idank/keyboards/README.md

# About

This repo contains pcb and 3d files for keyboards. The keyboards are adaptations of popular open source keyboards with a variety of changes.

# Buy

Check [holykeebs.com][hk] for kits and prebuilt keyboards.

# License

This work is licensed under a
[Creative Commons Attribution-ShareAlike 4.0 International License][cc-by-sa].

[cc-by-sa]: http://creativecommons.org/licenses/by-sa/4.0/
[hk]: https://holykeebs.com
