idank/keyboards/chocorne hotswap/oled cover.dxf

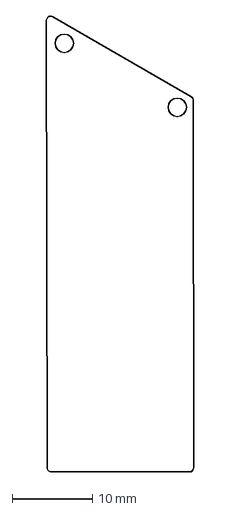
[picture p1: CAD file, 2023-08-10]
chocorne hotswap/oled cover.dxf
18.3 x 56.7 mm
