idank/keyboards/corne/corne-light-smt/for smt.dxf

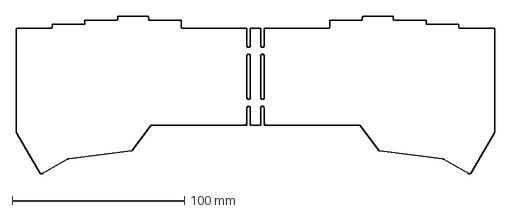
[picture p2: CAD file, 2024-01-29]
corne/corne-light-smt/for smt.dxf
277.5 x 91.4 mm
