idank/keyboards/lily58/choc plates/outline.dxf

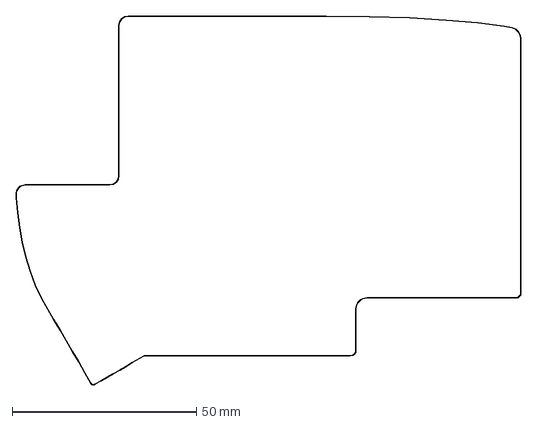
[picture p3: CAD file, 2024-03-17]
lily58/choc plates/outline.dxf
137.0 x 100.1 mm
