idank/keyboards/lily58/mx smt/smt.dxf

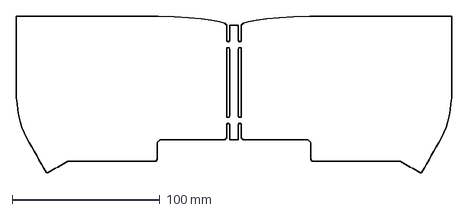
[picture p4: CAD file, 2024-03-26]
lily58/mx smt/smt.dxf
295.0 x 106.3 mm
