idank/keyboards/mbk-3dmodels/1u.stl

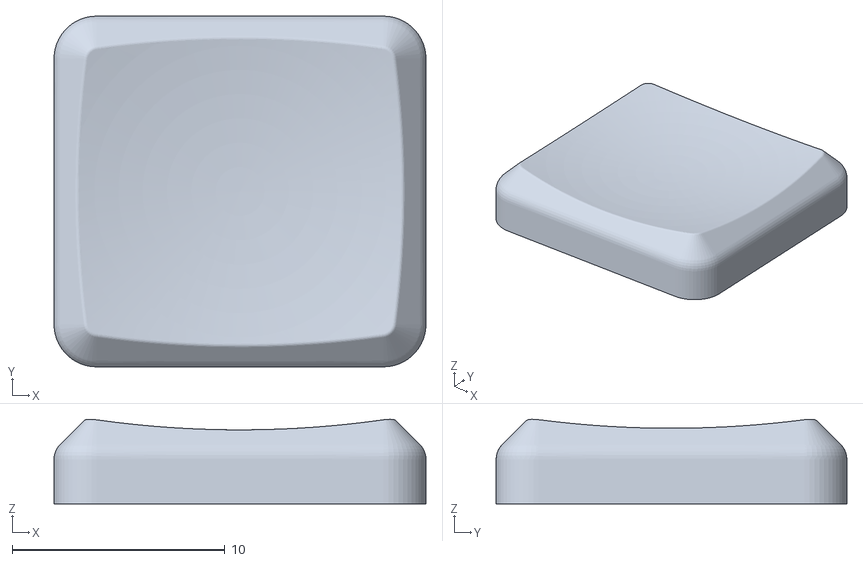
[picture p5: CAD file, 2023-08-22]
mbk-3dmodels/1u.stl
17.5 x 16.5 x 3.98
