idank/keyboards/printed-cases/corne low profile, 4mm spacers.stl

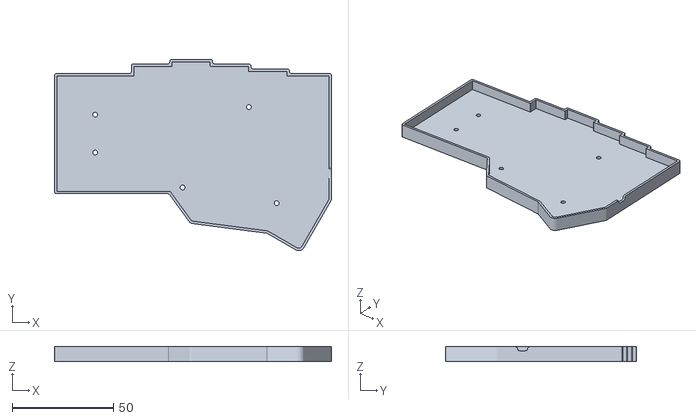
[picture p6: CAD file, 2026-04-15]
printed-cases/corne low profile, 4mm spacers.stl
137.0 x 94.6 x 7.20
