idank/keyboards/reviung/reviung41 choc/plate/41_1350_pcb_plate.step

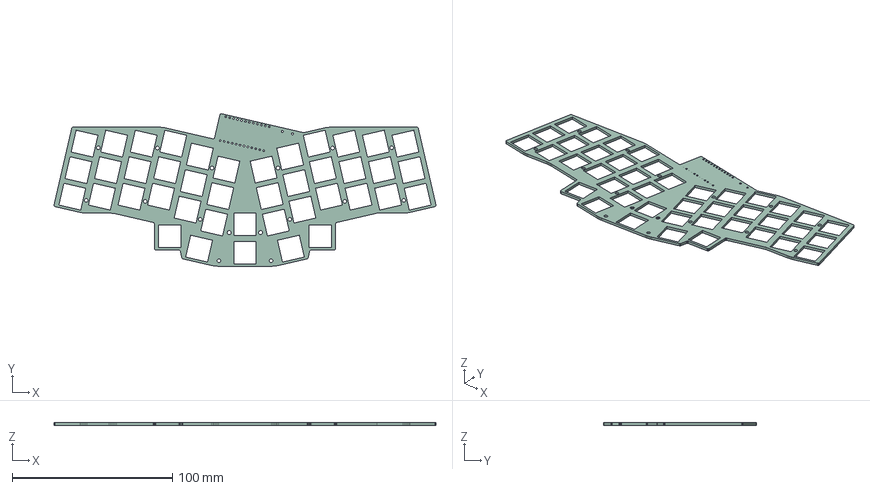
[picture p7: CAD file, 2023-06-27]
reviung/reviung41 choc/plate/41_1350_pcb_plate.step
238.7 x 95.3 x 1.58 mm
