idank/keyboards/reviung/reviung41 low profile/pcb/bottom plate.dxf

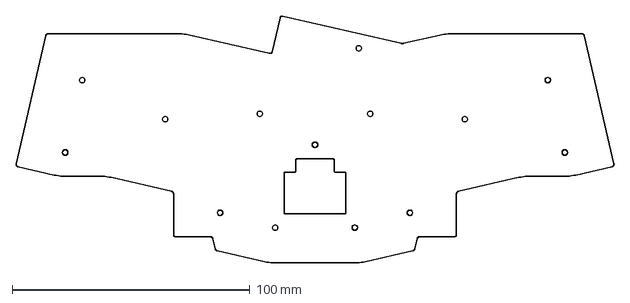
[picture p8: CAD file, 2023-08-24]
reviung/reviung41 low profile/pcb/bottom plate.dxf
251.3 x 103.7 mm
