idank/keyboards/reviung/reviung41 low profile/plate/reviung41 low profile plate.STEP

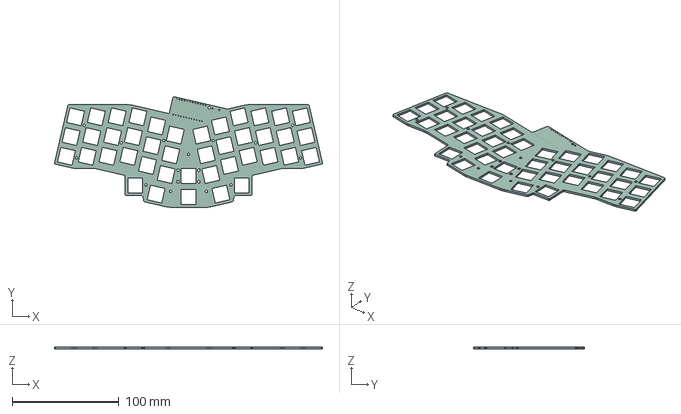
[picture p9: CAD file, 2023-07-04]
reviung/reviung41 low profile/plate/reviung41 low profile plate.STEP
251.3 x 103.7 x 1.60 mm
