idank/keyboards/sweeq/sweeq plate tenting holes.STEP

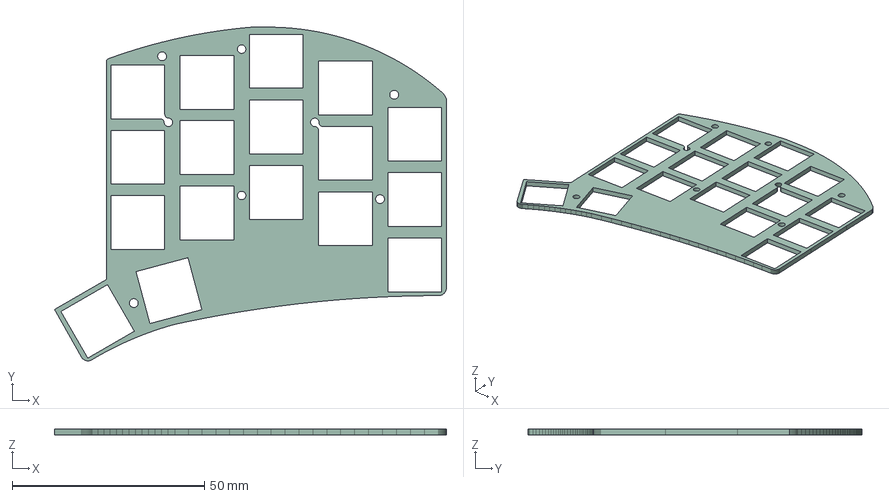
[picture p10: CAD file, 2024-02-10]
sweeq/sweeq plate tenting holes.STEP
102.0 x 86.9 x 1.58 mm
