idank/keyboards/TPS42/Case/3dp/outlines/keycaps_outline_3x6.dxf

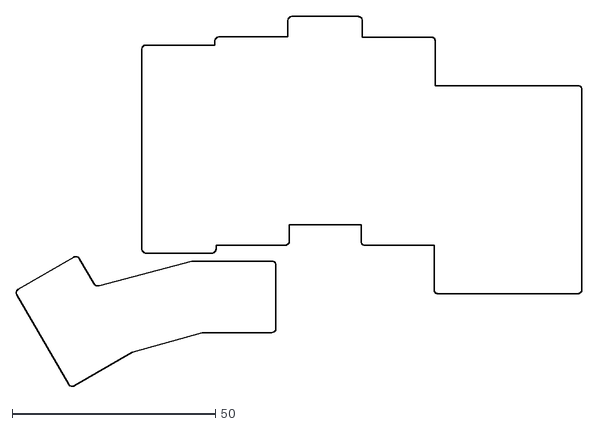
[picture p11: CAD file, 2023-07-06]
TPS42/Case/3dp/outlines/keycaps_outline_3x6.dxf
139.3 x 91.2
