idank/keyboards/TPS42/PCB/TPS42/TPS42.step

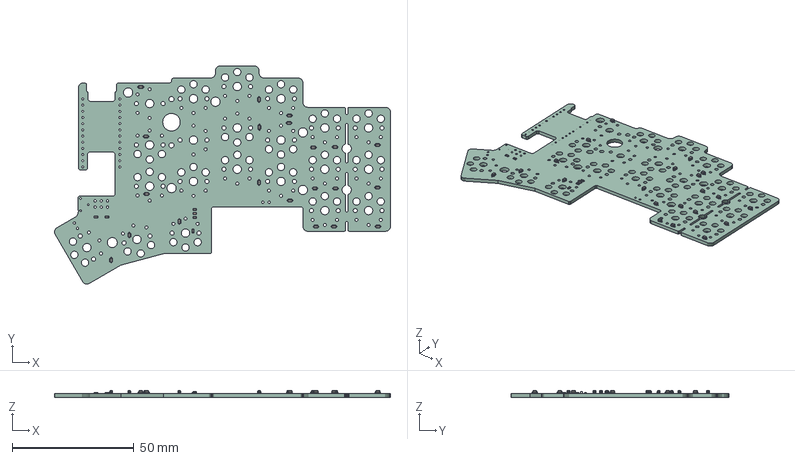
[picture p12: CAD file, 2023-07-06]
TPS42/PCB/TPS42/TPS42.step
138.1 x 89.7 x 2.73 mm
PCB
