idank/keyboards/chocorne hotswap/chococorne hotswap plate.step

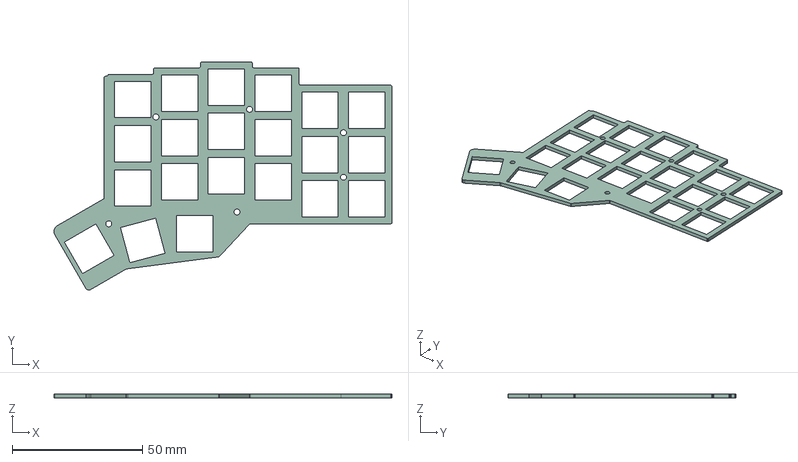
[picture p13: CAD file, 2023-08-10]
chocorne hotswap/chococorne hotswap plate.step
130.0 x 87.7 x 1.58 mm
