idank/keyboards/corne/corne-light-smt/corne-light-brd.dxf

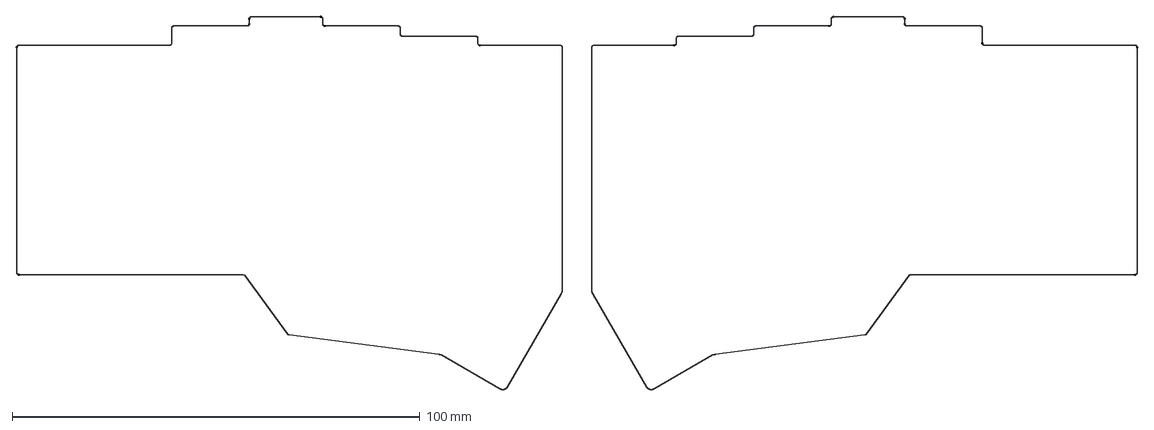
[picture p14: CAD file, 2024-01-29]
corne/corne-light-smt/corne-light-brd.dxf
274.9 x 91.5 mm
