idank/keyboards/lily58/mx smt/Lily58.step

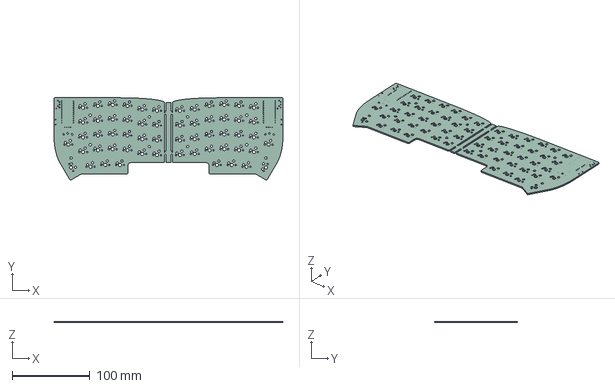
[picture p15: CAD file, 2024-03-26]
lily58/mx smt/Lily58.step
295.0 x 106.3 x 1.60 mm
