idank/keyboards/mbk-3dmodels/1.5ux.stl

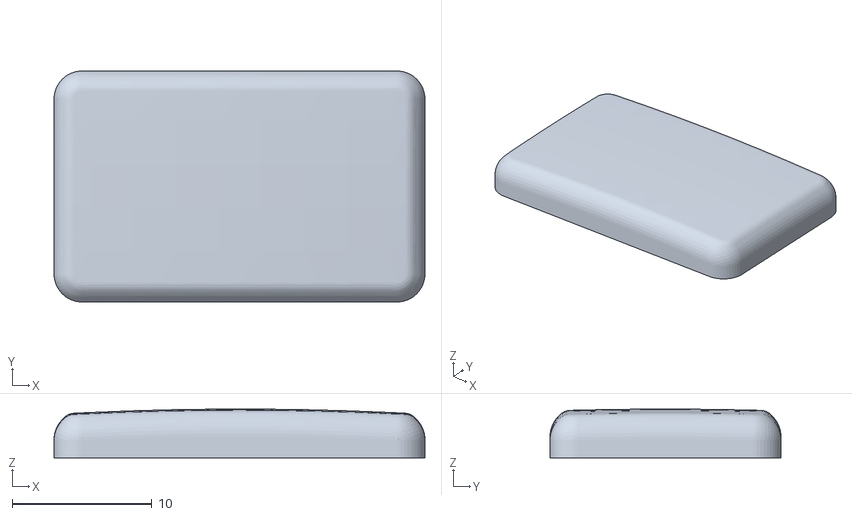
[picture p16: CAD file, 2023-08-22]
mbk-3dmodels/1.5ux.stl
26.5 x 16.5 x 3.49
