idank/keyboards/printed-cases/corne cherry low profile sockets, 7mm spaces, 1.2mm top.3mf

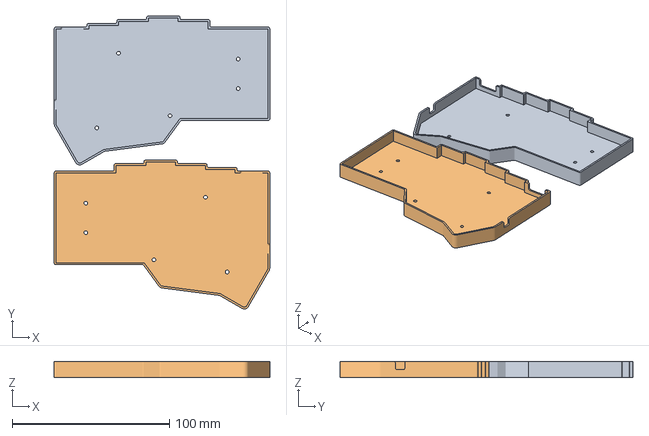
[picture p17: CAD file, 2026-04-15]
printed-cases/corne cherry low profile sockets, 7mm spaces, 1.2mm top.3mf
137.0 x 186.1 x 10.2 mm
corne cherry low profile sockets, 7mm spaces, 1.2mm top.stl x 2
