idank/keyboards/sweeq/sweeq.dxf

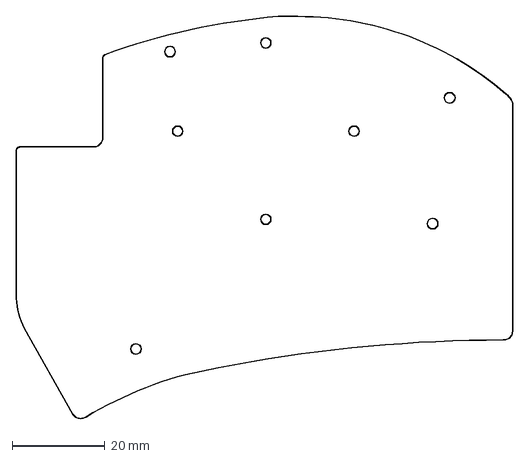
[picture p18: CAD file, 2023-09-06]
sweeq/sweeq.dxf
107.2 x 86.9 mm
