idank/keyboards/TPS42/Case/3dp/outlines/pcb_outline.dxf

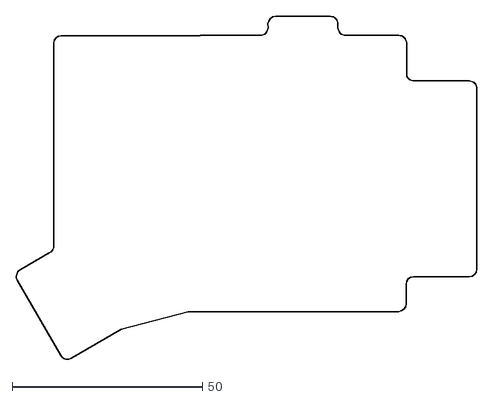
[picture p19: CAD file, 2023-07-06]
TPS42/Case/3dp/outlines/pcb_outline.dxf
121.1 x 90.2
