idank/keyboards/chocorne hotswap/chococorne hotswap.step

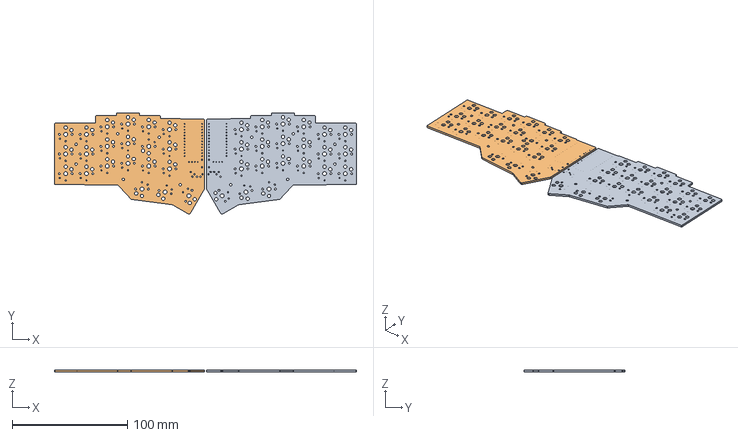
[picture p20: CAD file, 2023-07-17]
chocorne hotswap/chococorne hotswap.step
261.7 x 87.7 x 1.58 mm
PCB1
PCB2
