idank/keyboards/mbk-3dmodels/2ux.stl

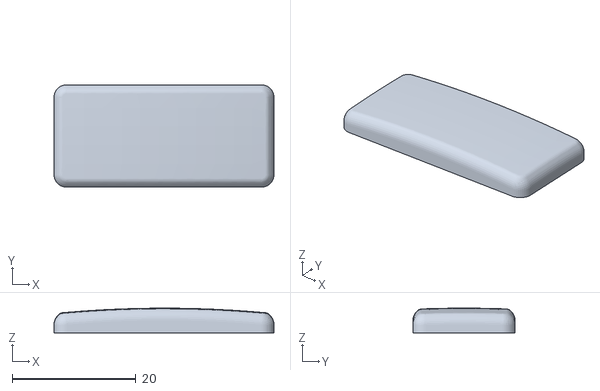
[picture p21: CAD file, 2023-08-22]
mbk-3dmodels/2ux.stl
35.5 x 16.5 x 3.99
