idank/keyboards/printed-cases/lily58 mx, 7mm spacers low profile sockets.3mf

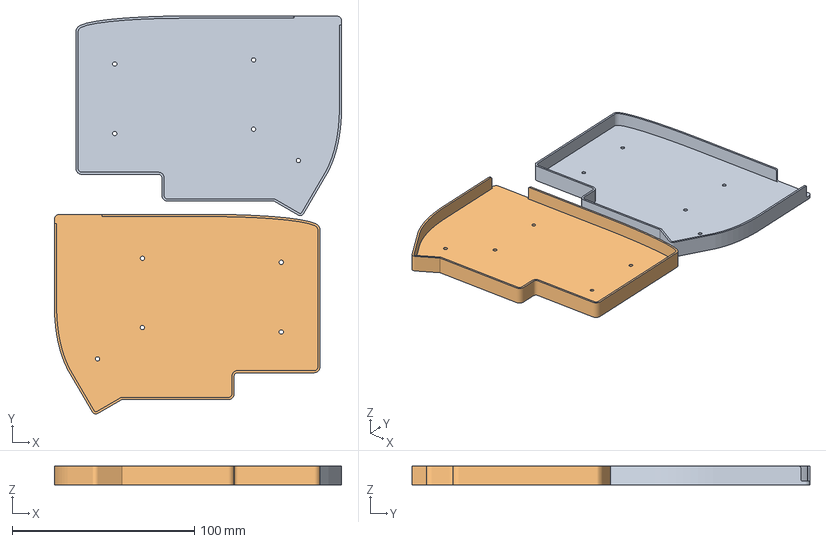
[picture p22: CAD file, 2026-04-15]
printed-cases/lily58 mx, 7mm spacers low profile sockets.3mf
157.5 x 218.4 x 10.2 mm
lily58 mx, 7mm spacers low profile sockets.stl x 2
