idank/keyboards/sweeq/sweeq plate with tenting holes.dxf

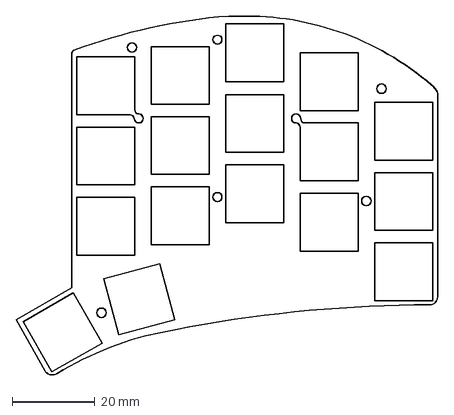
[picture p23: CAD file, 2023-09-03]
sweeq/sweeq plate with tenting holes.dxf
102.0 x 86.9 mm
