idank/keyboards/TPS42/Case/3dp/outlines/keycaps_outline.dxf

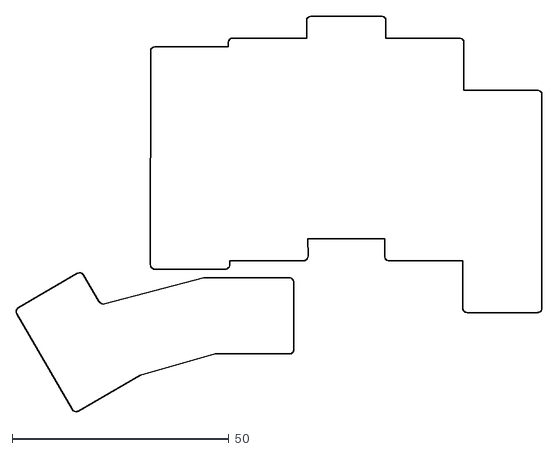
[picture p24: CAD file, 2023-07-06]
TPS42/Case/3dp/outlines/keycaps_outline.dxf
121.2 x 91.2
