idank/keyboards/chocorne hotswap/chococorne-Edge_Cuts.dxf

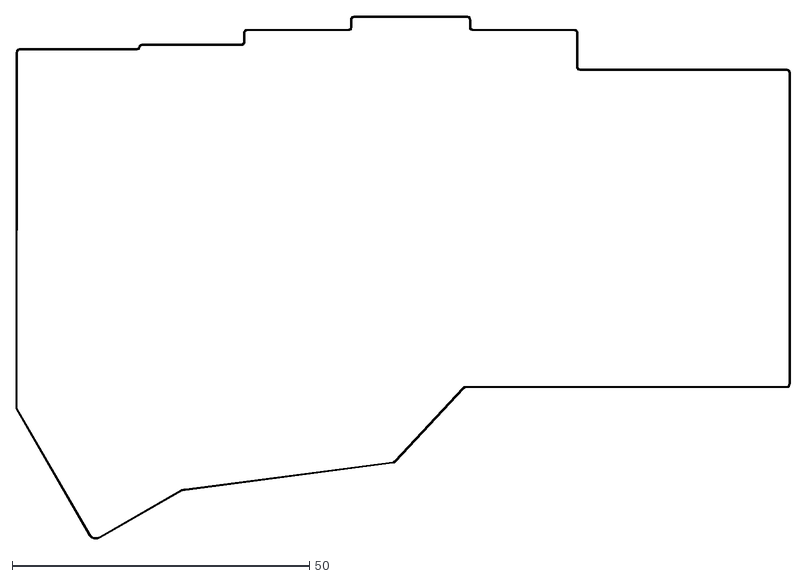
[picture p25: CAD file, 2023-07-16]
chocorne hotswap/chococorne-Edge_Cuts.dxf
130.1 x 87.9
