idank/keyboards/mbk-3dmodels/2.25u.stl

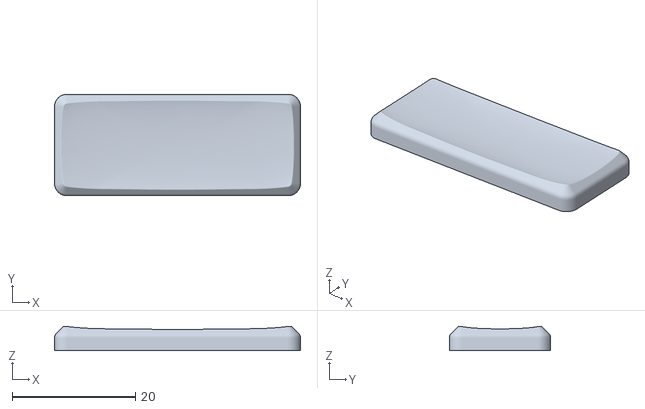
[picture p26: CAD file, 2023-08-22]
mbk-3dmodels/2.25u.stl
40.0 x 16.5 x 3.97
