idank/keyboards/printed-cases/lily lp 4mm spacers 1.6.3mf

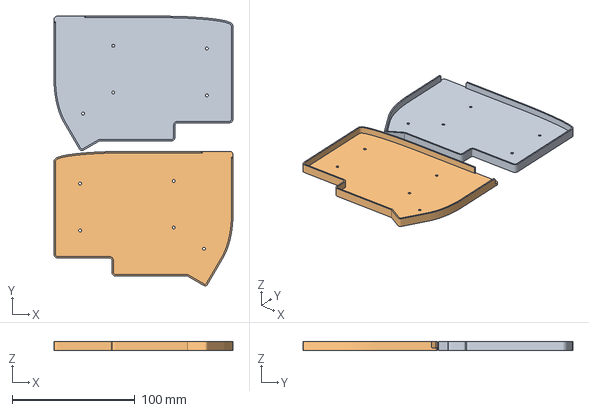
[picture p27: CAD file, 2026-04-15]
printed-cases/lily lp 4mm spacers 1.6.3mf
145.7 x 219.6 x 7.60 mm
lily lp 4mm spacers 1.6.stl x 2
