idank/keyboards/TPS42/Case/3dp/outlines/switch_outline.dxf

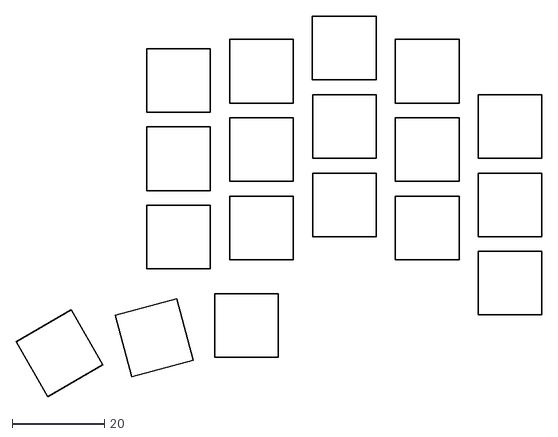
[picture p28: CAD file, 2023-07-06]
TPS42/Case/3dp/outlines/switch_outline.dxf
114.2 x 82.5
