idank/keyboards/chocorne hotswap/chococorne.step

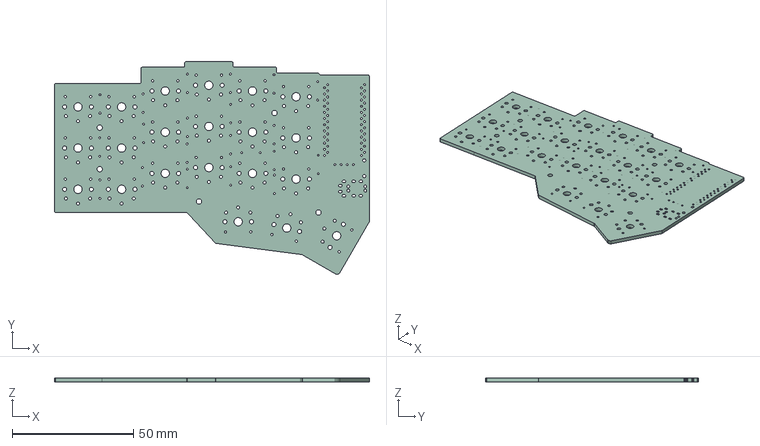
[picture p29: CAD file, 2023-05-10]
chocorne hotswap/chococorne.step
130.0 x 87.7 x 1.60 mm
