idank/keyboards/mbk-3dmodels/2.75u.stl

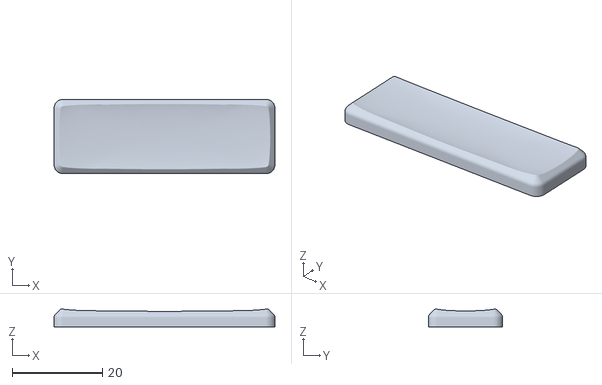
[picture p30: CAD file, 2023-08-22]
mbk-3dmodels/2.75u.stl
49.0 x 16.5 x 3.97
