idank/keyboards/printed-cases/sweeq, 4mm spacers.3mf

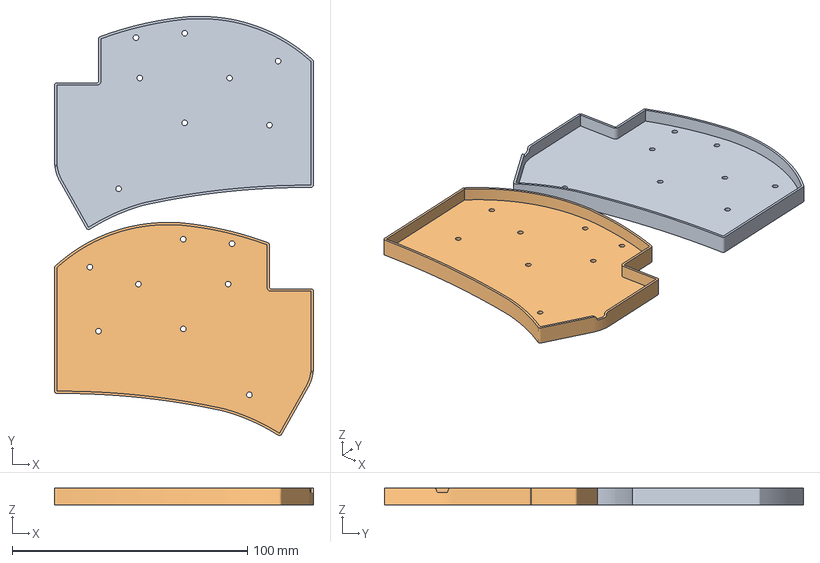
[picture p31: CAD file, 2026-04-15]
printed-cases/sweeq, 4mm spacers.3mf
110.0 x 178.1 x 7.20 mm
sweeq, 4mm spacers.stl x 2
