idank/keyboards/TPS42/Case/3dp/outlines/pcb_outline_3x6.dxf

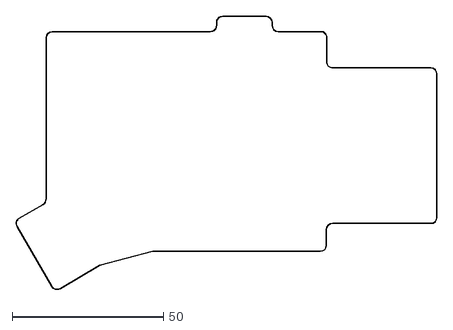
[picture p32: CAD file, 2023-07-06]
TPS42/Case/3dp/outlines/pcb_outline_3x6.dxf
139.0 x 90.2
