idank/keyboards/mbk-3dmodels/1.5u.stl

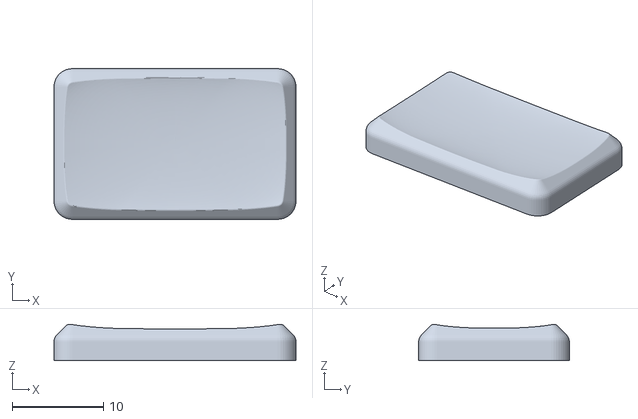
[picture p33: CAD file, 2023-08-22]
mbk-3dmodels/1.5u.stl
26.5 x 16.5 x 3.97
