idank/keyboards/printed-cases/span, 5mm spacers.3mf

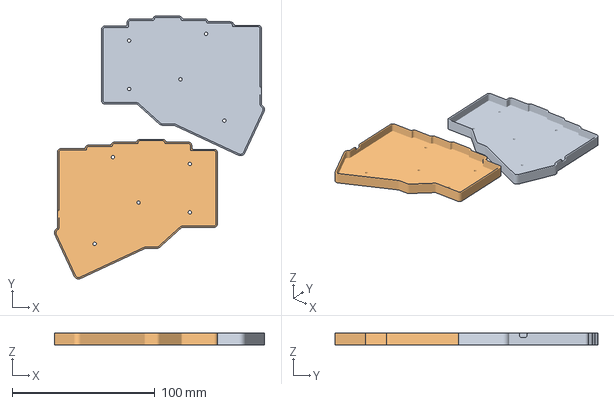
[picture p34: CAD file, 2026-04-15]
printed-cases/span, 5mm spacers.3mf
147.5 x 184.6 x 8.20 mm
span, 5mm spacers.stl x 2
