idank/keyboards/TPS42/Case/3dp/outlines/switch_outline_3x6.dxf

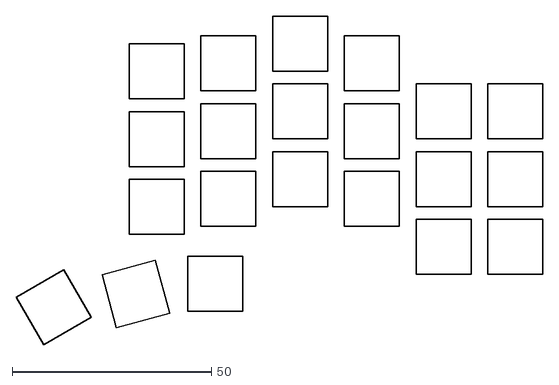
[picture p35: CAD file, 2023-07-06]
TPS42/Case/3dp/outlines/switch_outline_3x6.dxf
132.1 x 82.5
