idank/keyboards/mbk-3dmodels/2u.stl

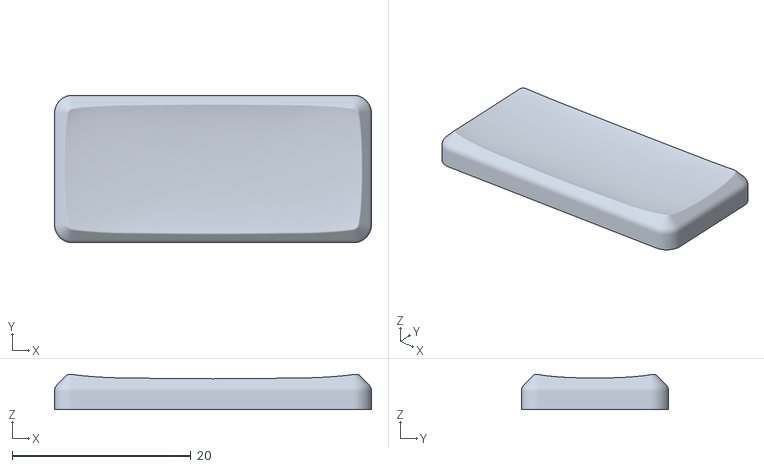
[picture p36: CAD file, 2023-08-22]
mbk-3dmodels/2u.stl
35.5 x 16.5 x 3.97
