idank/keyboards/printed-cases/corne choc, 4mm spacers.3mf

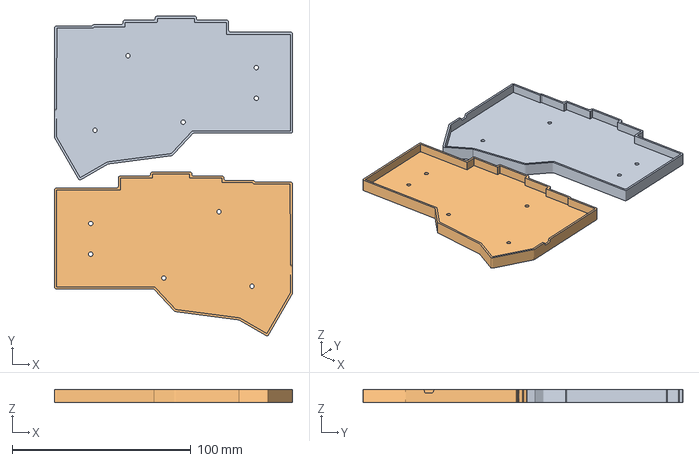
[picture p37: CAD file, 2026-04-15]
printed-cases/corne choc, 4mm spacers.3mf
133.2 x 178.9 x 7.20 mm
corne choc, 4mm spacers.stl x 2
