idank/keyboards/mbk-3dmodels/1uh.stl

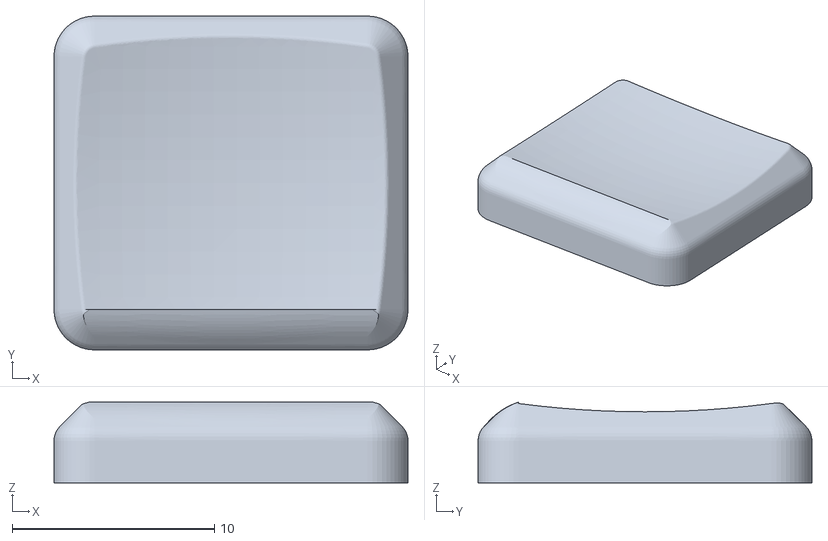
[picture p38: CAD file, 2023-08-22]
mbk-3dmodels/1uh.stl
17.5 x 16.5 x 4.00
