idank/keyboards/printed-cases/span, 4mm spacers.stl

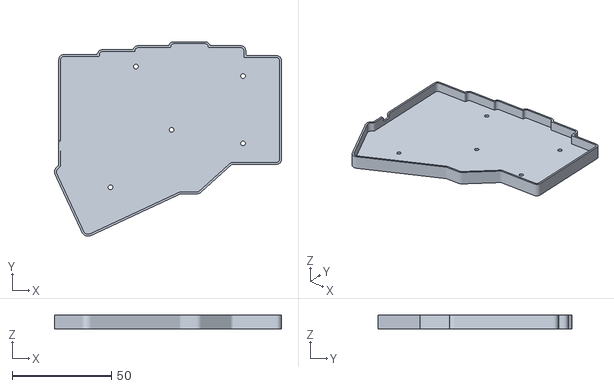
[picture p39: CAD file, 2026-04-15]
printed-cases/span, 4mm spacers.stl
114.4 x 98.0 x 7.20
