idank/keyboards/mbk-3dmodels/1.75u.stl

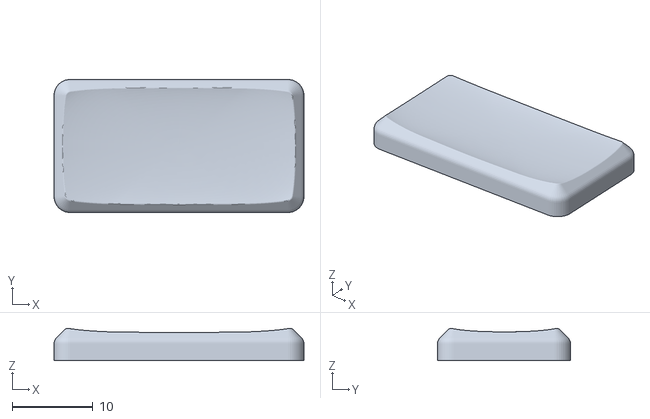
[picture p40: CAD file, 2023-08-22]
mbk-3dmodels/1.75u.stl
31.0 x 16.5 x 3.97
