idank/keyboards/printed-cases/lily choc 4mm spacers.3mf

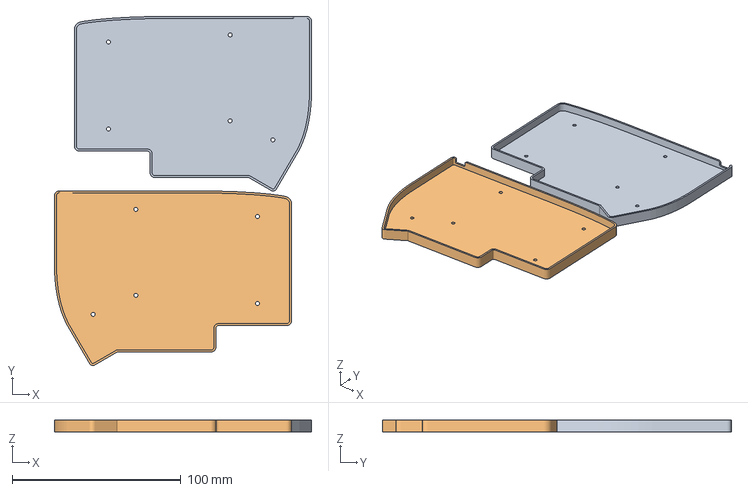
[picture p41: CAD file, 2026-04-15]
printed-cases/lily choc 4mm spacers.3mf
152.1 x 206.6 x 7.20 mm
lily choc 4mm spacers.stl x 2
