idank/keyboards/mbk-3dmodels/6.25ux.stl

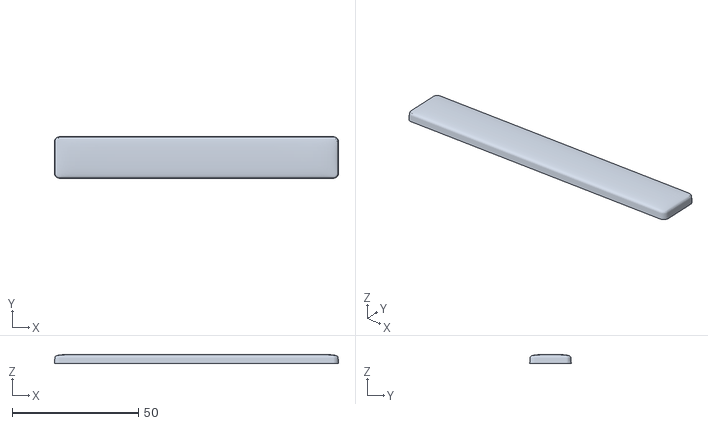
[picture p42: CAD file, 2023-08-22]
mbk-3dmodels/6.25ux.stl
112.5 x 16.5 x 3.74
