idank/keyboards/printed-cases/sweeq mx low profile sockets.3mf

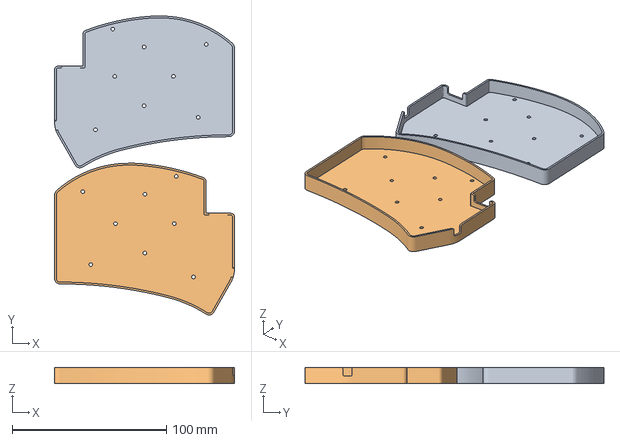
[picture p43: CAD file, 2026-04-15]
printed-cases/sweeq mx low profile sockets.3mf
116.7 x 193.7 x 10.6 mm
sweeq mx low profile sockets.stl x 2
