idank/keyboards/mbk-3dmodels/1.25u.stl

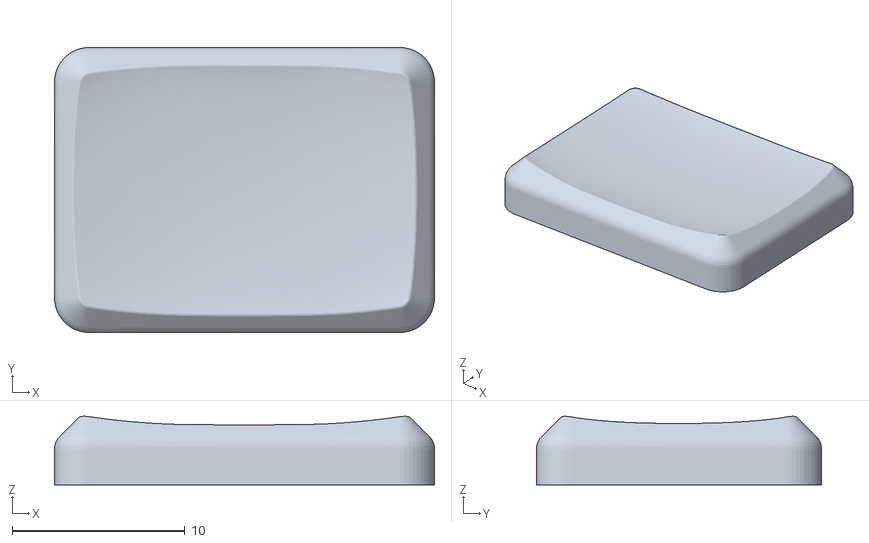
[picture p44: CAD file, 2023-08-22]
mbk-3dmodels/1.25u.stl
22.0 x 16.5 x 3.97
