idank/keyboards/printed-cases/touchpad cover right.stl

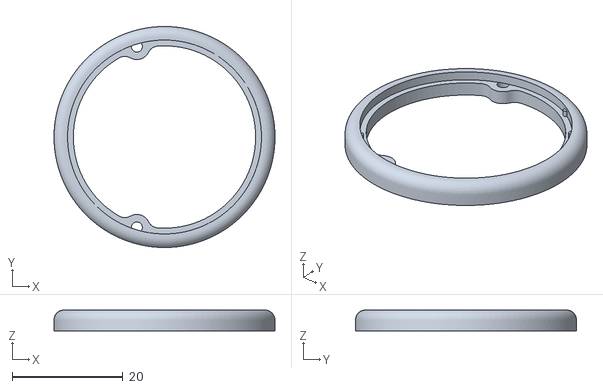
[picture p45: CAD file, 2024-04-29]
printed-cases/touchpad cover right.stl
40.0 x 40.0 x 3.80
