idank/keyboards/printed-cases/corne choc.dxf

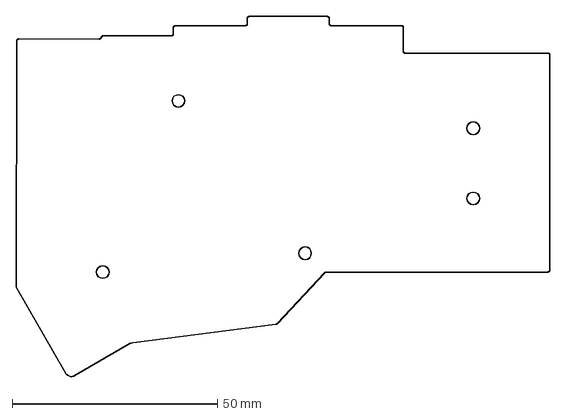
[picture p46: CAD file, 2024-04-29]
printed-cases/corne choc.dxf
130.0 x 87.7 mm
