idank/keyboards/printed-cases/touchpad cover left.stl

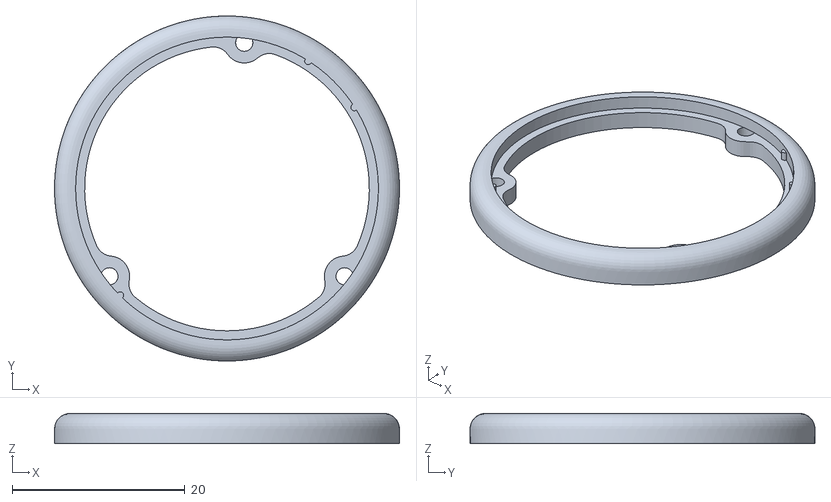
[picture p47: CAD file, 2024-04-29]
printed-cases/touchpad cover left.stl
40.0 x 40.0 x 3.50
