idank/keyboards/printed-cases/lily58, 4mm spacers, trackpoint groove.stl

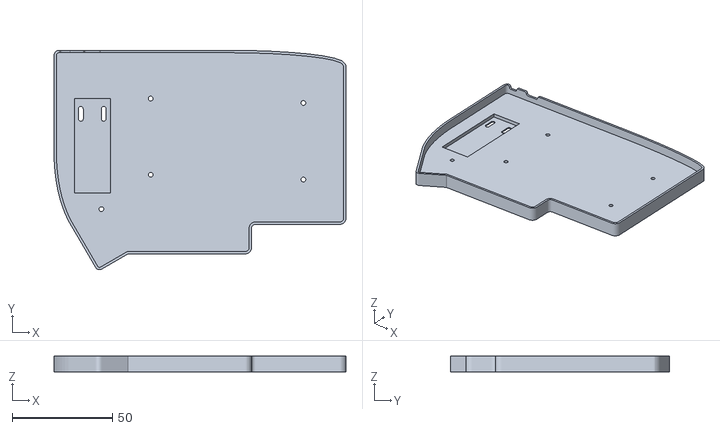
[picture p48: CAD file, 2024-04-29]
printed-cases/lily58, 4mm spacers, trackpoint groove.stl
145.7 x 109.5 x 7.80
