idank/keyboards/printed-cases/1mm_spacer.stl

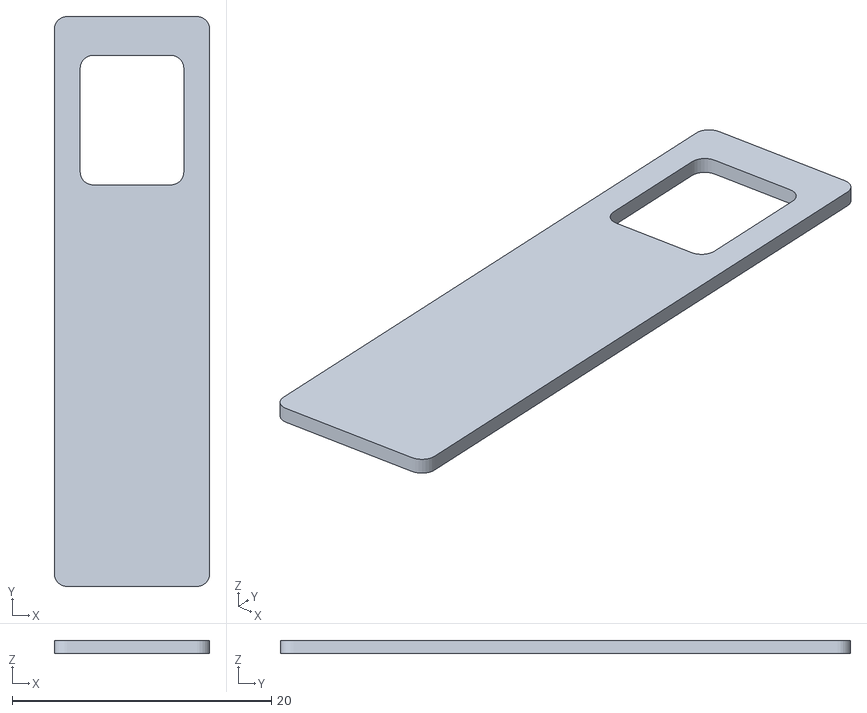
[picture p49: CAD file, 2024-04-29]
printed-cases/1mm_spacer.stl
12.0 x 44.0 x 1.00
