idank/keyboards/printed-cases/case.step

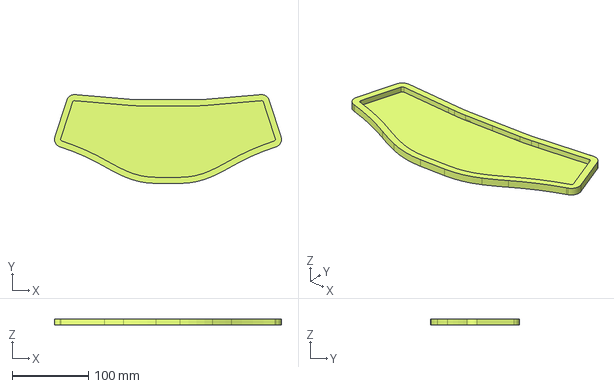
[picture p50: CAD file, 2024-04-29]
printed-cases/case.step
297.1 x 116.3 x 8.00 mm
