idank/keyboards/printed-cases/lily58, 4mm spacers.stl

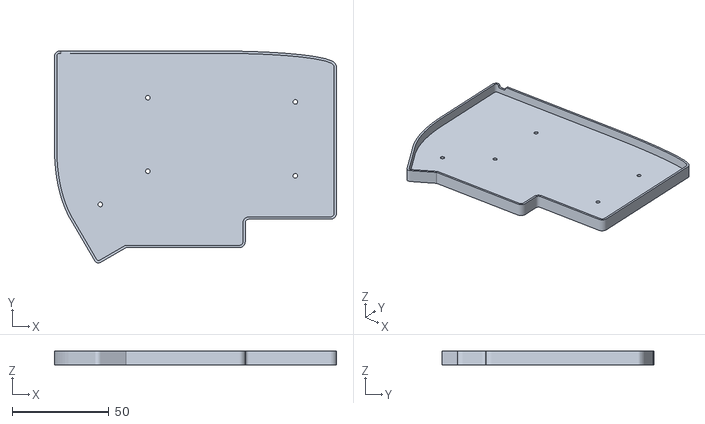
[picture p51: CAD file, 2024-04-29]
printed-cases/lily58, 4mm spacers.stl
145.7 x 109.5 x 7.20
