idank/keyboards/printed-cases/lily58 mx, 8mm spacers.stl

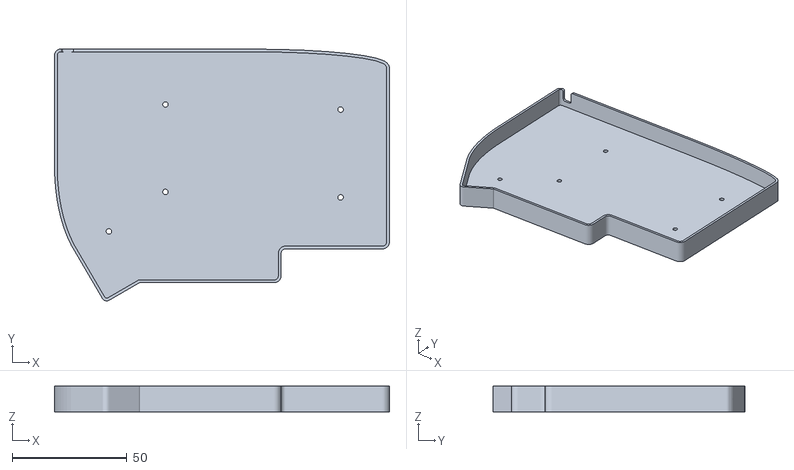
[picture p52: CAD file, 2024-04-29]
printed-cases/lily58 mx, 8mm spacers.stl
145.7 x 109.5 x 11.2
