idank/keyboards/printed-cases/sample rect.stl

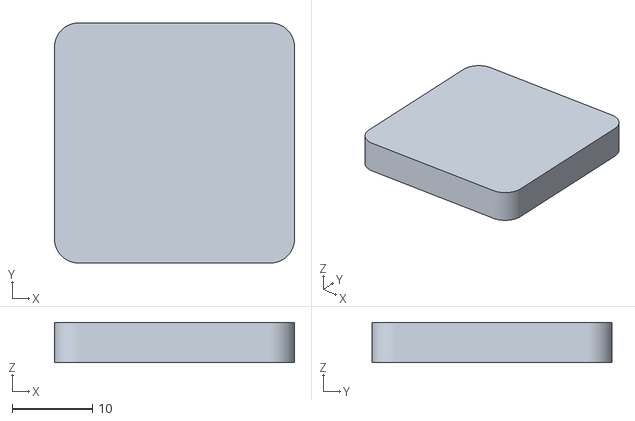
[picture p53: CAD file, 2024-04-29]
printed-cases/sample rect.stl
30.0 x 30.0 x 5.00
