idank/keyboards/printed-cases/eagle case.step

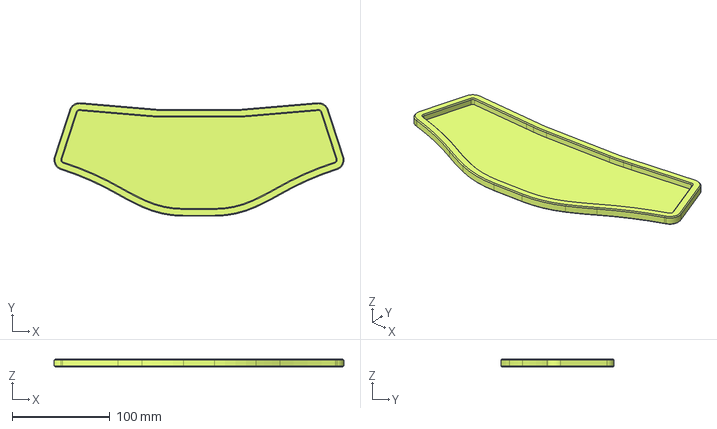
[picture p54: CAD file, 2024-04-29]
printed-cases/eagle case.step
297.1 x 116.3 x 8.00 mm
