idank/keyboards/printed-cases/sweeq right, 4mm spacers.stl

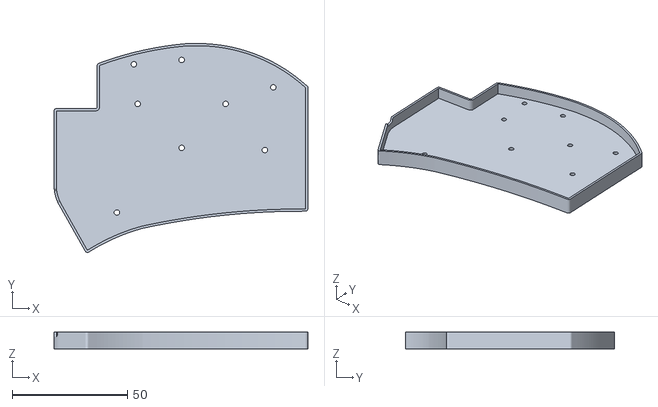
[picture p55: CAD file, 2024-04-29]
printed-cases/sweeq right, 4mm spacers.stl
110.0 x 90.5 x 7.20
