idank/keyboards/printed-cases/corne cherry, 8mm spaces, 1.2mm top.stl

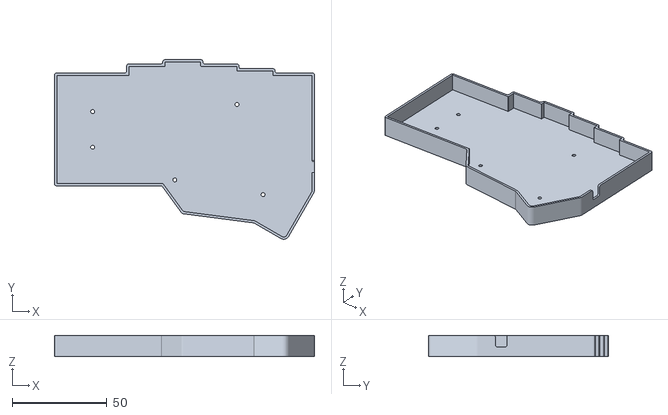
[picture p56: CAD file, 2024-04-29]
printed-cases/corne cherry, 8mm spaces, 1.2mm top.stl
137.0 x 94.6 x 11.2
