idank/keyboards/printed-cases/sweeq, 4mm spacers, trackpoint groove.stl

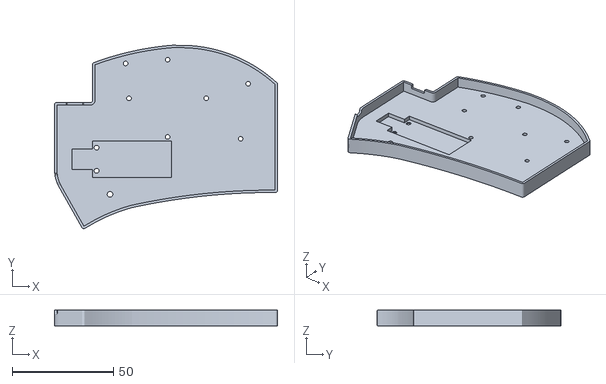
[picture p57: CAD file, 2024-01-06]
printed-cases/sweeq, 4mm spacers, trackpoint groove.stl
110.0 x 90.5 x 7.80
