idank/keyboards/(list of files, cad)

Other CAD files:
printed-cases/sweeq left, 4mm spacers.stl
chocorne hotswap/chococorne hotswap plate.dxf
chocorne hotswap/chococorne-B_Paste.dxf
printed-cases/corne cherry low profile sockets, 7mm spaces, 1.2mm top.stl
printed-cases/corne choc, 4mm spacers.stl
printed-cases/lily choc 4mm spacers.stl
printed-cases/lily lp 4mm spacers 1.6.stl
printed-cases/lily58 mx, 7mm spacers low profile sockets.stl
printed-cases/span, 5mm spacers.stl
printed-cases/sweeq mx low profile sockets.stl
reviung/reviung41 choc/plate/41_1350_pcb_plate.dxf
reviung/reviung41 low profile/plate/reviung41 low profile plate.dxf
