idank/keyboards/(threads)

Thread 3 (2023-11-05):

How is the pimoroni trackball mounted?

Michael-Tanzer, 2023-11-05:
Hi,

Sorry for the possibly stupid question. How is the pimoroni trackball soldered to the controller? I see on your website that you have a small PCB between the controller and the trackball to connect the right pins, is that available anywhere?

Thank you!

idank, 2023-11-05:
Hello!

That is not open source at this time. It can be purchased in kit form though: https://holykeebs.com/products/pimoroni-trackball-module.

Michael-Tanzer, 2023-11-05:
I'd love to get a whole PCB kit but I am looking at printing a PCB with a custom silkscreen and it doesn't seem to be available as an option

idank, 2023-11-05:
The trackball pcb isn't visible though, why do you need it as well?

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
