idank/keyboards/(list of files, drawings)

Other design files:
keyball/keyball61/right/keyball61_right1.dsn
