idank/keyboards/TPS42/PCB/TPS42/TPS42.kicad_pcb

## KiCad design TPS42/PCB/TPS42/TPS42.kicad_pcb (2023-07-06)

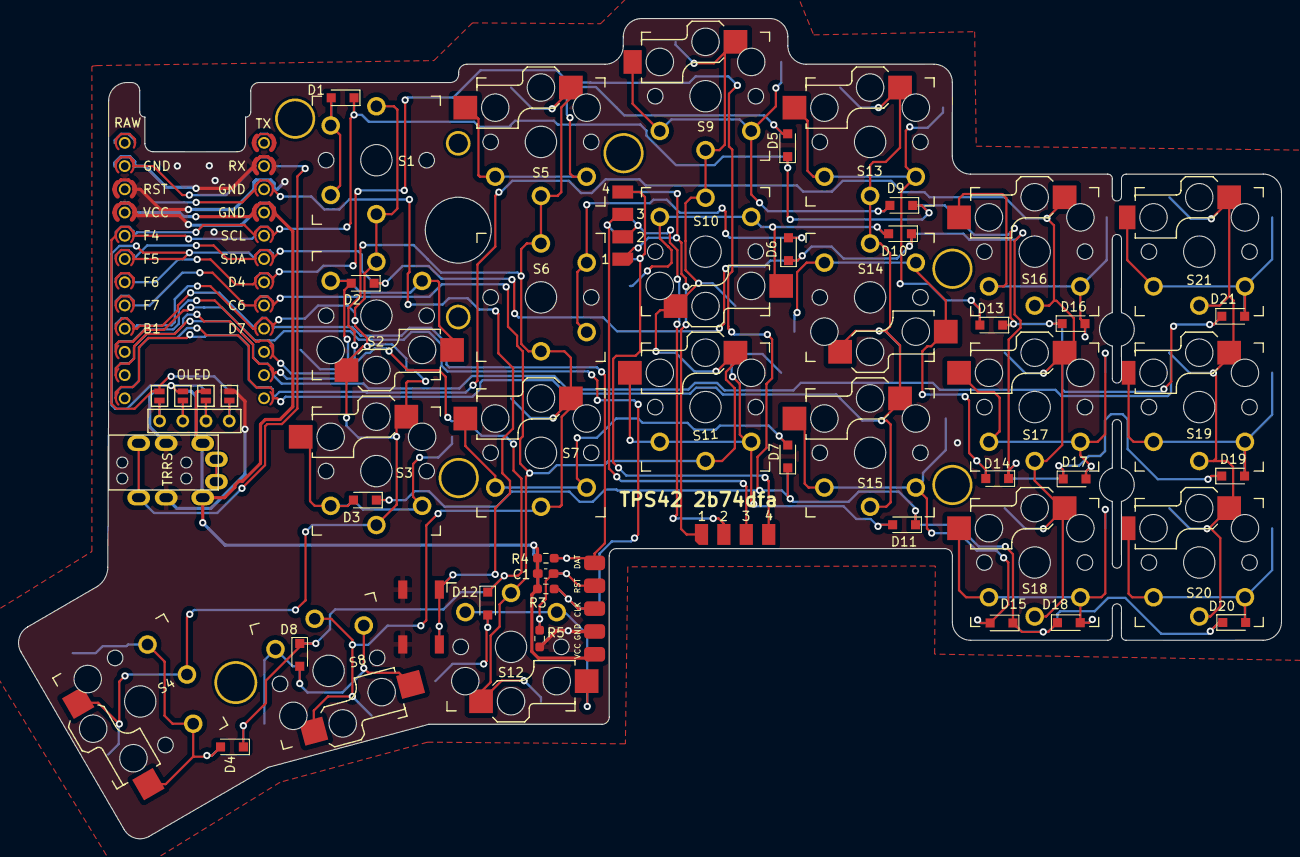
[picture p61: board TPS42.kicad_pcb from above]

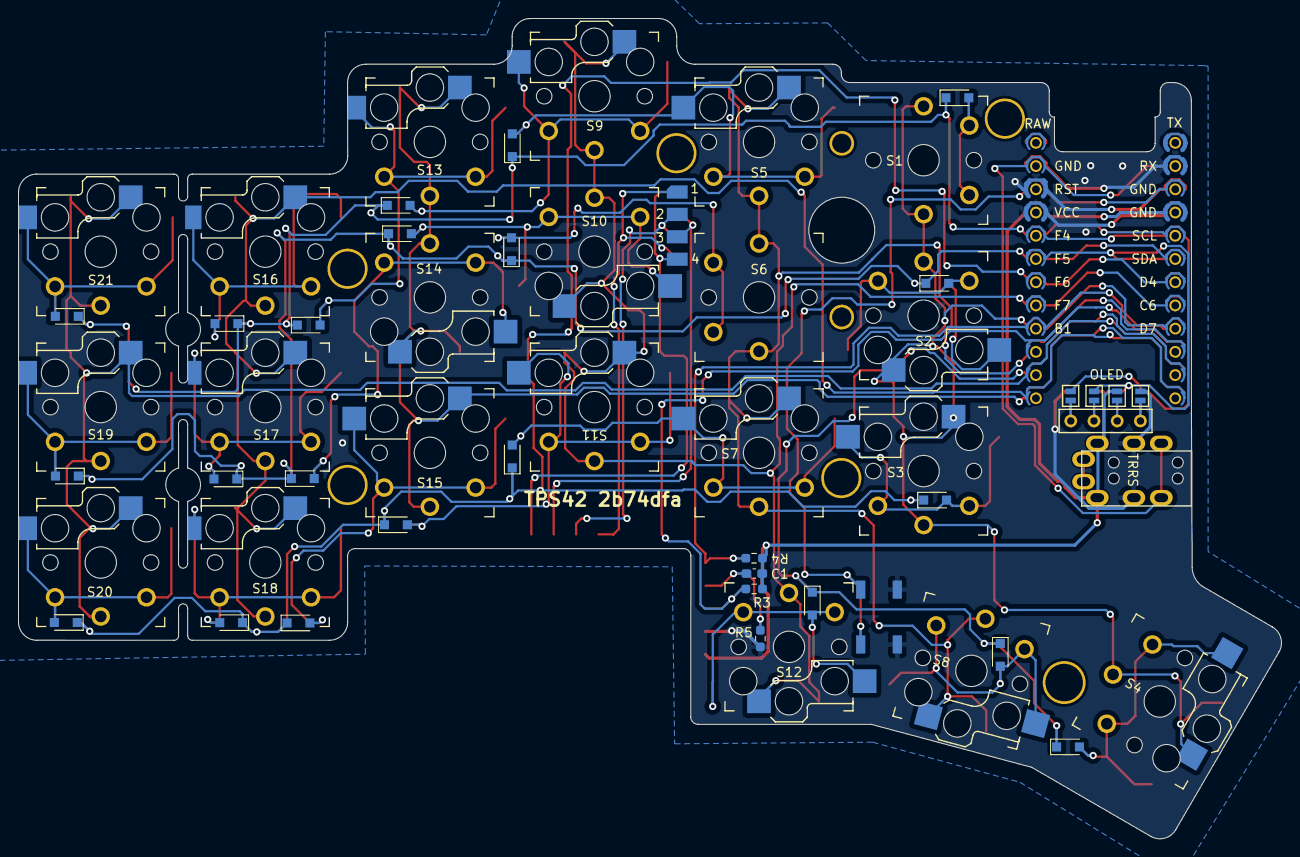
[picture p62: board TPS42.kicad_pcb from below]

Board: 2 copper layers, 138.1 x 89.7 mm, 71 parts (7 on the bottom side), 48 nets.

Parts:
C1: 2.2uF; C_0603_1608Metric_Pad1.08x0.95mm_HandSolder_Reversable
D1, D2, D3, D4, D5, D6, D7, D8, D9, D10, D11, D12, D13, D14, D15, D16, D17, D18, D19, D20, D21: D_Small; D_SOD-323_HandSoldering_Reversable
J1: MJ-4PP-9
J2: OLED
J3, J9: TP Sensor Module; TPSensorModule_Connector
J4: TP Module; TPSensorModule_Connector
J7: TrackPoint; TPModule
JP1, JP2, JP3, JP4, JP5, JP6, JP7, JP8: Jumper
R3, R4: 4.7kΩ; R_0603_1608Metric_Pad0.98x0.95mm_HandSolder_Reversable
R5: 100kΩ; R_0603_1608Metric_Pad0.98x0.95mm_HandSolder_Reversable
S1, S6: Switch; SW_PG1350_reversible
S2, S3, S5, S7, S8, S9, S10, S11, S12, S13, S14, S15, S16, S17, S18, S19, S20, S21: Switch; Kailh_socket_PG1350_optional_reversible.kicad_mod
S4: Switch; Kailh_socket_PG1350_125_optional_reversible.kicad_mod
SW2, SW3: Reset; SMD-SW-4_5.1x5.1x2.5
U1: ProMicro; ProMicro_Flipped_v2_A
U4, U5, U7, U8, U9, U12: Hole; HOLE_M2_TH
U11: Hole; TPSensorModule
U14: ProMicro; ProMicro_Flipped_v2_B

Connections:
COL0: S1.1, S2.1, S3.1, S4.1, U1.16 (B1/15), U14.16 (B1/15)
COL1: S5.1, S6.1, S7.1, S8.1, U1.15 (B3/14), U14.15 (B3/14)
COL2: S9.1, S10.1, S11.1, S12.1, U1.17 (F7/A0), U14.17 (F7/A0)
COL3: S13.1, S14.1, S15.1, U1.13 (B6/10), U14.13 (B6/10)
COL4: S16.1, S17.1, S18.1, U1.12 (9/B5), U14.12 (9/B5)
COL5: S19.1, S20.1, S21.1, U1.11 (8/B4), U14.11 (8/B4)
GND: J1.C, J7.4, JP1.1, JP8.1, R5.2, SW2.1, SW3.1, U1.3 (GND), U1.4 (GND), U1.23 (GND), U14.3 (GND), U14.4 (GND), U14.23 (GND)
unnamed: D1.2 (A), S1.2
unnamed: D2.2 (A), S2.2
unnamed: D3.2 (A), S3.2
unnamed: D4.2 (A), S4.2
unnamed: D5.2 (A), S5.2
unnamed: D6.2 (A), S6.2
unnamed: D7.2 (A), S7.2
unnamed: D8.2 (A), S8.2
unnamed: D9.2 (A), S9.2
unnamed: D10.2 (A), S10.2
unnamed: D11.2 (A), S11.2
unnamed: D12.2 (A), S12.2
unnamed: D13.2 (A), S13.2
unnamed: D14.2 (A), S14.2
unnamed: D15.2 (A), S15.2
unnamed: D16.2 (A), S16.2
unnamed: D17.2 (A), S17.2
unnamed: D18.2 (A), S18.2
unnamed: D19.2 (A), S19.2
unnamed: D20.2 (A), S20.2
unnamed: D21.2 (A), S21.2
unnamed: J2.1, JP4.2, JP8.2
unnamed: J2.2, JP3.2, JP7.2
unnamed: J2.3, JP2.2, JP6.2
unnamed: J2.4, JP1.2, JP5.2
unnamed: J3.1, J4.1, J9.1
unnamed: J3.2, J4.2, J9.2
unnamed: J3.3, J4.3, J9.3
unnamed: J3.4, J4.4, J9.4
unnamed: C1.2, J7.2, R5.1
RESET: SW2.2, SW3.2, U1.22 (RST), U14.22 (RST)
ROW0: D1.1 (K), D5.1 (K), D9.1 (K), D13.1 (K), D16.1 (K), D21.1 (K), U1.20 (F4/A3), U14.20 (F4/A3)
ROW1: D2.1 (K), D6.1 (K), D10.1 (K), D14.1 (K), D17.1 (K), D19.1 (K), U1.19 (F5/A2), U14.19 (F5/A2)
ROW2: D3.1 (K), D7.1 (K), D11.1 (K), D15.1 (K), D18.1 (K), D20.1 (K), U1.18 (F6/A1), U14.18 (F6/A1)
ROW3: D4.1 (K), D8.1 (K), D12.1 (K), U1.14 (B2/16), U14.14 (B2/16)
SCL: JP3.1, JP6.1, U1.6 (3/D0/SCL), U14.6 (3/D0/SCL)
SDA: JP4.1, JP5.1, U1.5 (2/D1/SDA), U14.5 (2/D1/SDA)
SERIAL: J1.B, U1.2 (RX1/D2), U14.2 (RX1/D2)
TP_CLK: J7.3, R3.2, U1.10 (7/E6), U14.10 (7/E6)
TP_DATA: J7.1, R4.2, U1.9 (6/D7), U14.9 (6/D7)
VCC: C1.1, J1.D, J7.5, JP2.1, JP7.1, R3.1, R4.1, U1.21 (VCC), U14.21 (VCC)
