idank/keyboards/keyball/keyball61/left/keyball61_Left.sch

## KiCad design keyball/keyball61/left/keyball61_Left.sch (2024-03-22)

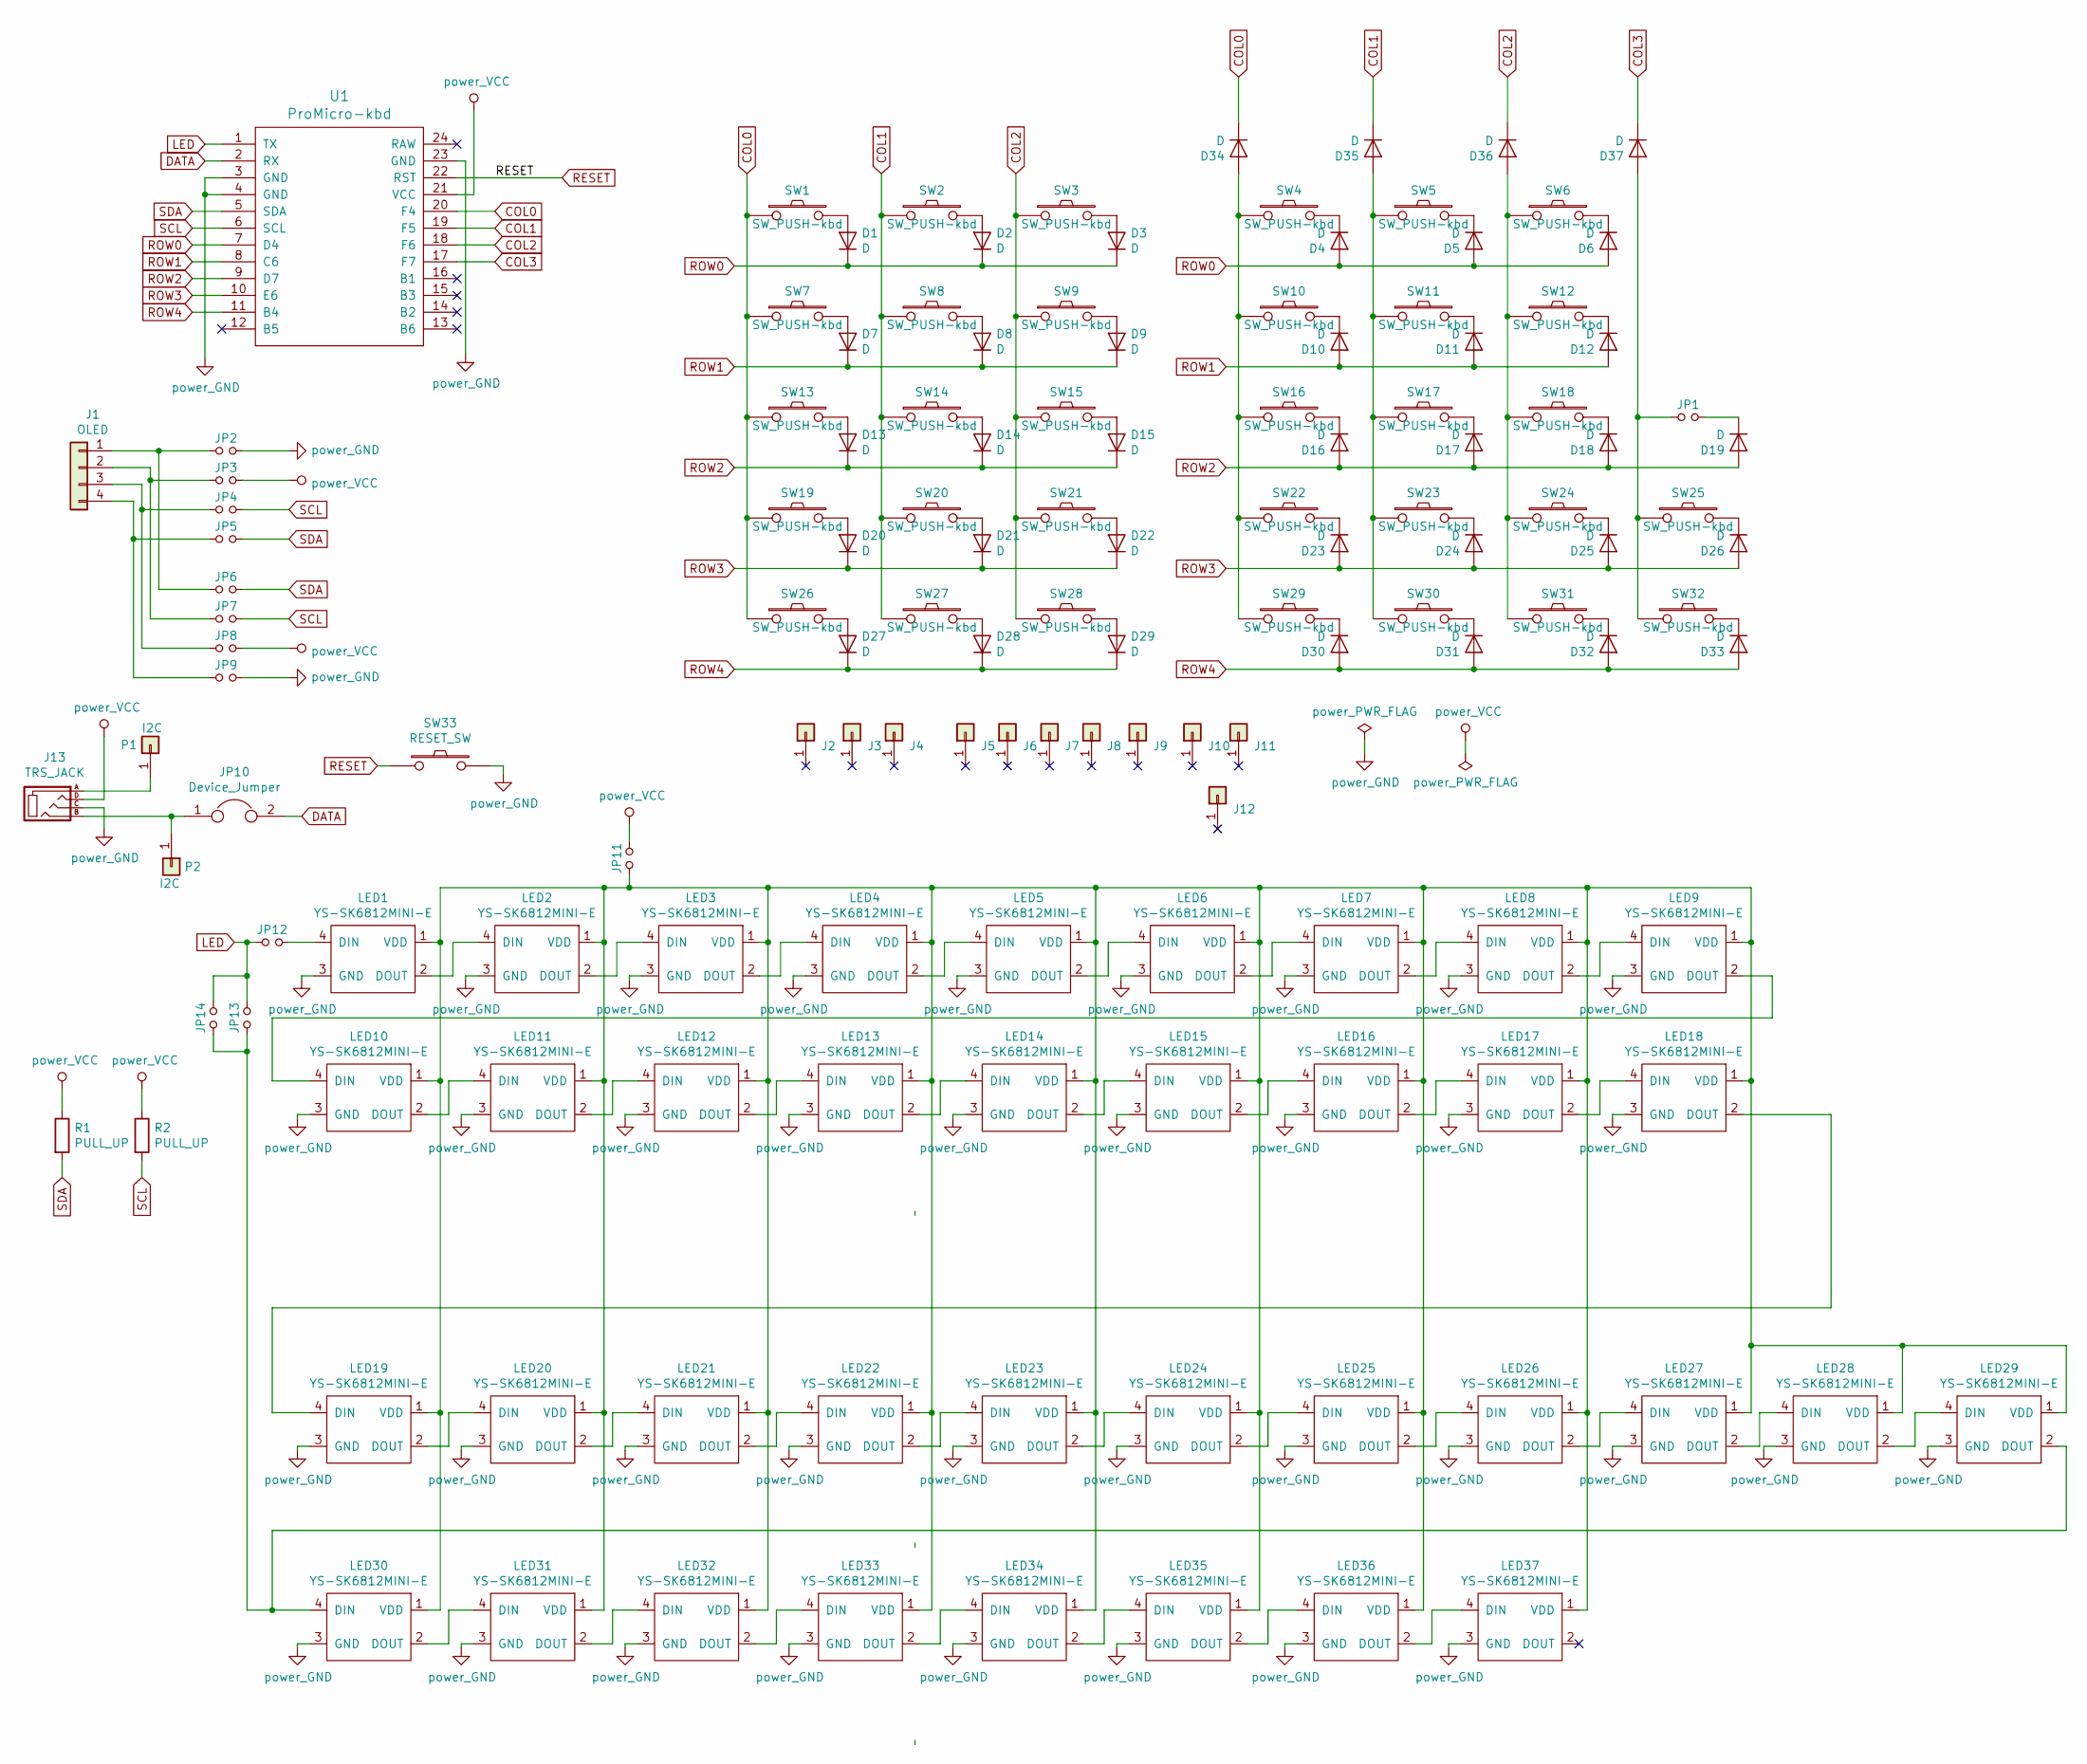
[picture p63: schematic keyball61_Left.sch]

Parts:
D1, D2, D3, D4, D5, D6, D7, D8, D9, D10, D11, D12, D13, D14, D15, D16, D17, D18, D19, D20, D21, D22, D23, D24, D25, D26, D27, D28, D29, D30, D31, D32, D33, D34, D35, D36, D37: D; D3_SMD_v2_BOTH
J1: OLED
J2, J3: Conn_01x01-Connector_Generic; MountingHole_2.2mm_M2_Pad
J4, J5, J6, J7, J8, J9, J10, J11, J12: Conn_01x01-Connector_Generic; MountingHole_4.3mm_M4
J13: TRS_JACK; TRRS_JACK_MJ4PP9
JP1, JP2, JP3, JP4, JP5, JP6, JP7, JP8, JP9, JP13, JP14: Device_Jumper_NO_Small; Jumper
JP10: Device_Jumper; JP025
JP11: Device_Jumper_NO_Small; JP06
JP12: Device_Jumper_NO_Small; JP025
LED1, LED2, LED3, LED4, LED5, LED6, LED7, LED8, LED9, LED10, LED11, LED12, LED13, LED14, LED15, LED16, LED17, LED18, LED19, LED20, LED21, LED22, LED23, LED24, LED25, LED26, LED27, LED28, LED29: YS-SK6812MINI-E; YS-SK6812MINI-Keyball-TL
LED30, LED31, LED32, LED33, LED34, LED35, LED36, LED37: YS-SK6812MINI-E; YS-SK6812MINI-Keyball-BL
P1, P2: I2C; 1pin_conn
R1, R2: PULL_UP; R_0603_1608Metric
SW1, SW2, SW3, SW4, SW5, SW6, SW7, SW8, SW9, SW10, SW11, SW12, SW13, SW14, SW15, SW16, SW17, SW18, SW19, SW20, SW21, SW22, SW23, SW24, SW25, SW26, SW27, SW28, SW29: SW_PUSH-kbd; CherryMX_MidHeight_Hotswap
SW30, SW31, SW32: SW_PUSH-kbd; MX&Choc_V1_V2_Hotswap_BOTH
SW33: RESET_SW; ResetSW
U1: ProMicro-kbd; ProMicro_v2_for61

Connections:
COL0: D34.1 (K), SW1.1, SW7.1, SW13.1, SW19.1, SW26.1, U1.20 (F4)
COL1: D35.1 (K), SW2.1, SW8.1, SW14.1, SW20.1, SW27.1, U1.19 (F5)
COL2: D36.1 (K), SW3.1, SW9.1, SW15.1, SW21.1, SW28.1, U1.18 (F6)
COL3: D37.1 (K), U1.17 (F7)
DATA: JP10.2, U1.2 (RX)
LED: JP12.1, JP13.2, JP14.2, U1.1 (TX)
unnamed: D1.2 (A), SW1.2
unnamed: D2.2 (A), SW2.2
unnamed: D3.2 (A), SW3.2
unnamed: D4.1 (K), SW4.2
unnamed: D5.1 (K), SW5.2
unnamed: D6.1 (K), SW6.2
unnamed: D7.2 (A), SW7.2
unnamed: D8.2 (A), SW8.2
unnamed: D9.2 (A), SW9.2
unnamed: D10.1 (K), SW10.2
unnamed: D11.1 (K), SW11.2
unnamed: D12.1 (K), SW12.2
unnamed: D13.2 (A), SW13.2
unnamed: D14.2 (A), SW14.2
unnamed: D15.2 (A), SW15.2
unnamed: D16.1 (K), SW16.2
unnamed: D17.1 (K), SW17.2
unnamed: D18.1 (K), SW18.2
unnamed: D19.1 (K), JP1.2
unnamed: D20.2 (A), SW19.2
unnamed: D21.2 (A), SW20.2
unnamed: D22.2 (A), SW21.2
unnamed: D23.1 (K), SW22.2
unnamed: D24.1 (K), SW23.2
unnamed: D25.1 (K), SW24.2
unnamed: D26.1 (K), SW25.2
unnamed: D27.2 (A), SW26.2
unnamed: D28.2 (A), SW27.2
unnamed: D29.2 (A), SW28.2
unnamed: D30.1 (K), SW29.2
unnamed: D31.1 (K), SW30.2
unnamed: D32.1 (K), SW31.2
unnamed: D33.1 (K), SW32.2
unnamed: D34.2 (A), SW4.1, SW10.1, SW16.1, SW22.1, SW29.1
unnamed: D35.2 (A), SW5.1, SW11.1, SW17.1, SW23.1, SW30.1
unnamed: D36.2 (A), SW6.1, SW12.1, SW18.1, SW24.1, SW31.1
unnamed: D37.2 (A), JP1.1, SW25.1, SW32.1
unnamed: J1.1, JP2.1, JP6.1
unnamed: J1.2, JP3.1, JP7.1
unnamed: J1.3, JP4.1, JP8.1
unnamed: J1.4, JP5.1, JP9.1
unnamed: J13.A, P1.1
unnamed: J13.B, JP10.1, P2.1
unnamed: JP11.1, LED1.1 (VDD), LED2.1 (VDD), LED3.1 (VDD), LED4.1 (VDD), LED5.1 (VDD), LED6.1 (VDD), LED7.1 (VDD), LED8.1 (VDD), LED9.1 (VDD), LED10.1 (VDD), LED11.1 (VDD), LED12.1 (VDD), LED13.1 (VDD), LED14.1 (VDD), LED15.1 (VDD), LED16.1 (VDD), LED17.1 (VDD), LED18.1 (VDD), LED19.1 (VDD), LED20.1 (VDD), LED21.1 (VDD), LED22.1 (VDD), LED23.1 (VDD), LED24.1 (VDD), LED25.1 (VDD), LED26.1 (VDD), LED27.1 (VDD), LED28.1 (VDD), LED29.1 (VDD), LED30.1 (VDD), LED31.1 (VDD), LED32.1 (VDD), LED33.1 (VDD), LED34.1 (VDD), LED35.1 (VDD), LED36.1 (VDD), LED37.1 (VDD)
unnamed: JP12.2, LED1.4 (DIN)
unnamed: JP13.1, JP14.1, LED29.2 (DOUT), LED30.4 (DIN)
unnamed: LED1.2 (DOUT), LED2.4 (DIN)
unnamed: LED2.2 (DOUT), LED3.4 (DIN)
unnamed: LED3.2 (DOUT), LED4.4 (DIN)
unnamed: LED4.2 (DOUT), LED5.4 (DIN)
unnamed: LED5.2 (DOUT), LED6.4 (DIN)
unnamed: LED6.2 (DOUT), LED7.4 (DIN)
unnamed: LED7.2 (DOUT), LED8.4 (DIN)
unnamed: LED8.2 (DOUT), LED9.4 (DIN)
unnamed: LED10.2 (DOUT), LED11.4 (DIN)
unnamed: LED9.2 (DOUT), LED10.4 (DIN)
unnamed: LED11.2 (DOUT), LED12.4 (DIN)
unnamed: LED12.2 (DOUT), LED13.4 (DIN)
unnamed: LED13.2 (DOUT), LED14.4 (DIN)
unnamed: LED14.2 (DOUT), LED15.4 (DIN)
unnamed: LED15.2 (DOUT), LED16.4 (DIN)
unnamed: LED16.2 (DOUT), LED17.4 (DIN)
unnamed: LED17.2 (DOUT), LED18.4 (DIN)
unnamed: LED18.2 (DOUT), LED19.4 (DIN)
unnamed: LED19.2 (DOUT), LED20.4 (DIN)
unnamed: LED20.2 (DOUT), LED21.4 (DIN)
unnamed: LED21.2 (DOUT), LED22.4 (DIN)
unnamed: LED22.2 (DOUT), LED23.4 (DIN)
unnamed: LED23.2 (DOUT), LED24.4 (DIN)
unnamed: LED24.2 (DOUT), LED25.4 (DIN)
unnamed: LED25.2 (DOUT), LED26.4 (DIN)
unnamed: LED26.2 (DOUT), LED27.4 (DIN)
unnamed: LED27.2 (DOUT), LED28.4 (DIN)
unnamed: LED28.2 (DOUT), LED29.4 (DIN)
unnamed: LED30.2 (DOUT), LED31.4 (DIN)
unnamed: LED31.2 (DOUT), LED32.4 (DIN)
unnamed: LED32.2 (DOUT), LED33.4 (DIN)
unnamed: LED33.2 (DOUT), LED34.4 (DIN)
unnamed: LED34.2 (DOUT), LED35.4 (DIN)
unnamed: LED35.2 (DOUT), LED36.4 (DIN)
unnamed: LED36.2 (DOUT), LED37.4 (DIN)
RESET: SW33.1, U1.22 (RST)
ROW0: D1.1 (K), D2.1 (K), D3.1 (K), D4.2 (A), D5.2 (A), D6.2 (A), U1.7 (D4)
ROW1: D7.1 (K), D8.1 (K), D9.1 (K), D10.2 (A), D11.2 (A), D12.2 (A), U1.8 (C6)
ROW2: D13.1 (K), D14.1 (K), D15.1 (K), D16.2 (A), D17.2 (A), D18.2 (A), D19.2 (A), U1.9 (D7)
ROW3: D20.1 (K), D21.1 (K), D22.1 (K), D23.2 (A), D24.2 (A), D25.2 (A), D26.2 (A), U1.10 (E6)
ROW4: D27.1 (K), D28.1 (K), D29.1 (K), D30.2 (A), D31.2 (A), D32.2 (A), D33.2 (A), U1.11 (B4)
SCL: JP4.2, JP7.2, R2.2, U1.6 (SCL)
SDA: JP5.2, JP6.2, R1.2, U1.5 (SDA)
power_GND: J13.C, JP2.2, JP9.2, LED1.3 (GND), LED2.3 (GND), LED3.3 (GND), LED4.3 (GND), LED5.3 (GND), LED6.3 (GND), LED7.3 (GND), LED8.3 (GND), LED9.3 (GND), LED10.3 (GND), LED11.3 (GND), LED12.3 (GND), LED13.3 (GND), LED14.3 (GND), LED15.3 (GND), LED16.3 (GND), LED17.3 (GND), LED18.3 (GND), LED19.3 (GND), LED20.3 (GND), LED21.3 (GND), LED22.3 (GND), LED23.3 (GND), LED24.3 (GND), LED25.3 (GND), LED26.3 (GND), LED27.3 (GND), LED28.3 (GND), LED29.3 (GND), LED30.3 (GND), LED31.3 (GND), LED32.3 (GND), LED33.3 (GND), LED34.3 (GND), LED35.3 (GND), LED36.3 (GND), LED37.3 (GND), SW33.2, U1.3 (GND), U1.4 (GND), U1.23 (GND)
power_VCC: J13.D, JP3.2, JP8.2, JP11.2, R1.1, R2.1, U1.21 (VCC)
