idank/keyboards/(commit log)

2023-03-03 add several keyboards with support for the pimoroni trackball in variou positions
    [Lily58-B_Cu.gbl, Lily58-B_Mask.gbs, Lily58-B_Silkscreen.gbo, Lily58-Edge_Cuts.gm1, Lily58-F_Cu.gtl, Lily58-F_Mask.gts, Lily58-F_Silkscreen.gto, Lily58-NPTH.drl]
2023-05-04 add submodule kicad libs
2023-05-10 add reviung41 choc hotswap 0.1
    [41_1350_pcb-B_Cu.gbl, 41_1350_pcb-B_Mask.gbs, 41_1350_pcb-B_Paste.gbp, 41_1350_pcb-B_Silkscreen.gbo, 41_1350_pcb-Edge_Cuts.gm1, 41_1350_pcb-F_Cu.gtl, 41_1350_pcb-F_Mask.gts, 41_1350_pcb-F_Paste.gtp]
2023-05-10 chocorne: add hotswap variant (v0.1)
    [chococorne hotswap.step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]
2023-06-13 sweep: add a variant with a matrix to free up SDA/SCL pins
    also make it hotswappable.
    [sweep plate.kicad_pcb, sweep.dsn, sweep.kicad_pcb, sweep.kicad_sch]
2023-06-13 corne/cherry: replace holes to fit m2 so a top plate isn't mandatory
    [corne-cherry.kicad_pcb, corne-cherry.kicad_sch]
2023-06-27 reviung41: add choc hotswappable (v0.2)
    [41_1350_pcb.kicad_pcb, 41_1350_pcb_plate.dxf, 41_1350_pcb_plate.kicad_pcb, 41_1350_pcb_plate.step, 41_1350_switchPlate.kicad_pcb, 41_1350_switchPlate.sch, r41l2.kicad_pcb]
2023-06-29 reviung41: add a variant with choc spacing, hybrid switch sockets and switch plate
    [41_1350_pcb-B_Cu.gbl, 41_1350_pcb-B_Mask.gbs, 41_1350_pcb-B_Paste.gbp, 41_1350_pcb-B_Silkscreen.gbo, 41_1350_pcb-Edge_Cuts.gm1, 41_1350_pcb-F_Cu.gtl, 41_1350_pcb-F_Mask.gts, 41_1350_pcb-F_Paste.gtp]
2023-06-29 reviung41: update version
    [reviung41 choc.kicad_pcb]
2023-07-04 reviung41: add low profile variant
    [r41l2-B_Cu.gbl, r41l2-B_Mask.gbs, r41l2-B_Paste.gbp, r41l2-B_Silkscreen.gbo, r41l2-Edge_Cuts.gm1, r41l2-F_Cu.gtl, r41l2-F_Mask.gts, r41l2-F_Paste.gtp]
2023-07-04 reviung41/low profile: bump version
    [reviung41 low profile.kicad_pcb]
2023-07-04 reviung low profile: add top plate
    [reviung41 low profile plate.STEP, reviung41 low profile plate.dxf, reviung41 low profile plate.kicad_pcb, reviung41 low profile plate.kicad_sch, reviung41 low profile.kicad_pcb]
2023-07-04 reviung lp: bump version
    [reviung41 low profile.kicad_pcb]
2023-07-06 TPS42: import v1.0
    [TPS42-LCD-Shield-B_Cu.gbr, TPS42-LCD-Shield-B_Mask.gbr, TPS42-LCD-Shield-B_Paste.gbr, TPS42-LCD-Shield-B_Silkscreen.gbr, TPS42-LCD-Shield-Edge_Cuts.gbr, TPS42-LCD-Shield-F_Cu.gbr, TPS42-LCD-Shield-F_Mask.gbr, TPS42-LCD-Shield-F_Paste.gbr]
2023-07-06 TPS42: clean up the pcb a bit, get rid of the oled/lcd shields
    [TPS42-LCD-Shield-B_Cu.gbr, TPS42-LCD-Shield-B_Mask.gbr, TPS42-LCD-Shield-B_Paste.gbr, TPS42-LCD-Shield-B_Silkscreen.gbr, TPS42-LCD-Shield-Edge_Cuts.gbr, TPS42-LCD-Shield-F_Cu.gbr, TPS42-LCD-Shield-F_Mask.gbr, TPS42-LCD-Shield-F_Paste.gbr]
2023-07-06 TPS42: bump version
    [TPS42.kicad_pcb]
2023-07-16 chocorne/hotswap: add plates
    [chococorne copy.step, chococorne hotswap plate.dxf, chococorne hotswap plate.kicad_pcb, chococorne hotswap plate.step, chococorne-B_Paste.dxf, chococorne-Edge_Cuts.dxf]
2023-07-17 chocorne hotswap: change switch footprint to oval
    [chococorne copy.step, chococorne hotswap.step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]
2023-07-18 chocorne hotswap: enlarge switch slot holes to 0.5 to comply with jlc capabilities
2023-07-19 chocorne: add oled cover m2 holes
    [chococorne hotswap plate.step, chococorne.kicad_pcb]
2023-07-19 chocorne: bump version
    [chococorne.kicad_pcb]
2023-07-28 clean up some unused files
    [sweeq.dsn, sweeq.kicad_pcb]
2023-08-02 sweeq: remove silkscreen from plate
    [sweeq plate.kicad_pcb]
2023-08-02 lily58: add pro pcb, make the trackball shield holes work for the left handed trackball
    [Lily58_Pro.kicad_pcb, Lily58_Pro.sch, Lily58_Pro_BOTTOM.kicad_pcb, Lily58_Pro_TOP.kicad_pcb]
2023-08-10 chocorne hotswap: rotate keyswitch on left side so it matches the others orientation
    [chococorne hotswap plate.step, oled cover.dxf]
2023-08-13 chocorne: remove one of the mounting holes that isn't used
    [chococorne hotswap plate.kicad_pcb]
2023-08-15 add span
    [outline.dxf, plate.dxf, span.kicad_pcb, span.kicad_sch]
2023-08-22 update idank-kicad-lib
2023-08-22 add mbk 3d models
    [1.25u.stl, 1.5u.stl, 1.5ux.stl, 1.75u.stl, 1u.stl, 1uh.stl, 2.25u.stl, 2.75u.stl]
2023-08-24 reviung: minor updates
    [bottom plate.dxf]
2023-08-29 lily58: convert to reversible choc hotswaps
    [Lily58-B_Cu.gbl, Lily58-B_Mask.gbs, Lily58-B_Silkscreen.gbo, Lily58-Edge_Cuts.gm1, Lily58-F_Cu.gtl, Lily58-F_Mask.gts, Lily58-F_Silkscreen.gto, Lily58-NPTH.drl]
2023-09-03 sweeq: add a switch plate that has the tenting holes as well
    [sweeq plate tenting holes.kicad_pcb, sweeq plate with tenting holes.dxf]
2023-09-03 update gitignore
    [Lily58_Pro.kicad_pcb, Lily58_Pro.sch, Lily58_Pro_BOTTOM.kicad_pcb, Lily58_Pro_TOP.kicad_pcb]
2023-09-03 lily58: add plates
    [Lily58_Pro_TOP.kicad_pcb]
2023-09-03 old chocorne: update before deletion
    [chococorne.kicad_pcb, chococorne.step]
2023-09-03 old chocorne: remove
    [chococorne-B_Cu.gbl, chococorne-B_Mask.gbs, chococorne-B_Silkscreen.gbo, chococorne-Edge_Cuts.gm1, chococorne-F_Cu.gtl, chococorne-F_Mask.gts, chococorne-F_Silkscreen.gto, chococorne-NPTH.drl]
2023-09-03 span: bump version
    [span.kicad_pcb]
2023-09-06 sweeq: move reset switch next to trrs jack, change ferris picture
    [sweeq plate.step, sweeq.dxf, sweeq.kicad_pcb]
2023-09-06 sweeq: bump version
    [sweeq.kicad_pcb]
2023-09-06 sweeq: switch to smaller pads on hotswap sockets
    [sweeq.kicad_pcb]
2023-09-06 sweeq: add the ferris graphics to the plate
    [sweeq plate tenting holes.kicad_pcb]
2023-09-07 span: move 2 of the thumb keys a bit
    [outline.dxf, span.kicad_pcb]
2023-09-07 sweeq: use m2 spacer holes on the pcb
    [sweeq.kicad_pcb]
2023-09-07 chocorne: move holes to m2 spacers footprint
    [chococorne hotswap plate.kicad_pcb, chococorne.kicad_pcb]
2023-09-07 lily: move holes to m2 spacers footprint
    [Lily58.kicad_pcb]
2023-09-07 lily: add holes for trackpoint shield
    [Lily58.kicad_pcb]
2023-09-07 corne: add light version with hotswaps
    [corne-light.kicad_pcb, corne-light.kicad_sch]
2023-09-07 corne light: bump version
    [corne-light.kicad_pcb]
2023-09-07 corne: add plates
    [corne-top-plate.kicad_pcb, corne-top-plate.sch]
2023-09-07 corne: add thumb hotswap variant
    [corne-thumb.kicad_pcb, corne-thumb.kicad_sch]
2023-09-07 span: change pcb holes to m2 spacers
    [span.kicad_pcb]
2023-09-30 sweeq: move a few diodes for m2 spacer clearance
    [sweeq.kicad_pcb]
2023-09-30 sweeq: fix bottom m2 holes to match tenting plates
    [sweeq.kicad_pcb]
2023-10-06 sweeq: move some tracks to make kicad happy
    [sweeq.kicad_pcb]
2023-10-08 corne/thumb: move thumb trackball to the 42nd key position
    [corne-thumb.kicad_pcb, corne-thumb.kicad_sch]
2023-10-08 corne/thumb: bump version
    [corne-thumb.kicad_pcb]
2023-10-15 corne thumb: update m2 spacer holes to be a tid bigger
    [corne-thumb.kicad_pcb]
2023-11-20 corne/cherry: fix m2 holes, we need the spacer to go through them
    [corne-cherry.kicad_pcb]
2023-11-20 corne/cherry: bump version
    [corne-cherry.kicad_pcb]
2023-11-21 lily: fix diode silk screen and remove some unused pads
    [Lily58.kicad_pcb, Lily58.kicad_sch, Lily58.step]
2023-12-24 chocorne: move top right mounting hole so screw head doesn't hit the switch edge
    [chococorne hotswap plate.kicad_pcb, chococorne.kicad_pcb]
2023-12-25 remove old sweep seapicro variant
    [sweepv2-B_Cu.gbr, sweepv2-B_Mask.gbr, sweepv2-B_Paste.gbr, sweepv2-B_Silkscreen.gbr, sweepv2-Edge_Cuts.gbr, sweepv2-F_Cu.gbr, sweepv2-F_Mask.gbr, sweepv2-F_Paste.gbr]
2024-01-06 add 3d printed cases
    [corne choc, 4mm spacers, trackpoint groove.stl, corne choc, 4mm spacers.stl, lily58, 4mm spacers, trackpoint groove.stl, lily58, 4mm spacers.stl, span, 4mm spacers, trackpoint groove.stl, span, 4mm spacers.stl, sweeq, 4mm spacers, trackpoint groove.stl, sweeq, 4mm spacers.stl]
2024-01-06 cases: add corne low profile
    [corne low profile, 4mm spacers.stl]
2024-01-23 corne-light: rotate SW41 so it's aligned the same as the rest
    clean up controller silkscreen
    [corne-light.kicad_pcb]
2024-01-23 corne-light: bump version
    [corne-light.kicad_pcb]
2024-01-29 corne-light: add smt version
    [corne-light-brd.dxf, corne-light.kicad_pcb, corne-light.kicad_sch, for smt.dxf]
2024-01-29 corne-light-smt: bump version
    [corne-light.kicad_pcb]
2024-02-10 sweeq: fix unconnected track, enlarged controller holes
    [sweeq plate tenting holes.STEP, sweeq plate.kicad_pcb, sweeq plate.step, sweeq.kicad_pcb]
2024-02-10 lily58: add mx variant (still wip)
    [Lily58.kicad_pcb, Lily58.kicad_sch, Lily58.step, lily.csv]
2024-02-13 add span changes before deleting due to move to separate repo
    [span.kicad_pcb]
2024-02-13 remove span from this repo
    [outline.dxf, plate.dxf, span.kicad_pcb, span.kicad_sch]
2024-03-14 corne-light-smt: initial version
    [corne-light-kikit.kicad_pcb, corne-light.kicad_sch, panel.kicad_pcb]
2024-03-16 add lily58 choc version
    [Lily58.kicad_pcb, Lily58.kicad_sch, Lily58.step, smt.dxf, smt2.dxf, spec.dxf]
2024-03-16 lily58 choc: bump version
    [Lily58.kicad_pcb]
2024-03-17 lily58 choc: move top edge and 1.5u key
    [Lily58.kicad_pcb, smt.dxf, spec.dxf]
2024-03-17 lily58 choc: add plates
    [lily58 choc plates.kicad_pcb, outline.dxf]
2024-03-22 add keyball61
    [keyball61_Left.sch, keyball61_right.sch, keyball61_right1.dsn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]
2024-03-26 lily58: add mx variant for smt
    [Lily58.kicad_pcb, Lily58.kicad_sch, Lily58.step, lily.csv, smt.dxf]
2024-03-28 sweeq: fix left side tenting holes being 1mm off
    [sweeq plate tenting holes.kicad_pcb, sweeq.kicad_pcb, sweeq.kicad_sch]
2024-03-28 sweeq: bummp version
    [sweeq.kicad_pcb]
2024-03-31 add a sweeq mx variant
    [sweep mx plate.kicad_pcb, sweeq mx.kicad_pcb, sweeq mx.kicad_sch]
2024-03-31 sweeq mx: bump version
    [sweeq mx.kicad_pcb]
2024-03-31 sweeq mx: add tabs
    [panel.kicad_pcb, sweeq mx.kicad_pcb]
2024-04-29 update printed cases
    [1mm_spacer.stl, case.step, corne cherry, 8mm spaces, 1.2mm top.stl, corne choc, 4mm spacers, trackpoint groove.stl, corne choc, 4mm spacers.stl, corne choc.dxf, eagle case.step, lily58 mx, 8mm spacers.stl]
2024-05-05 add corne cherry smt
    [corne-cherry.kicad_pcb, corne-cherry.kicad_sch, corne-cherry.sch]
2024-05-05 corne cherry: changes?
    [corne-cherry.kicad_pcb, corne-cherry.kicad_sch]
2024-05-09 corne choc: enlarge holes to 1mm
    [chococorne.kicad_pcb, chococorne.kicad_sch]
2024-05-09 corne choc: bump version
    [chococorne.kicad_pcb]
2024-05-09 lily58 choc: move trrs jack to the edge
    [Lily58.kicad_pcb, Lily58.step]
2024-05-22 corne/choc: add a variant with leds
    [corne choc plate.kicad_pcb, corne choc.kicad_pcb, corne choc.kicad_sch]
2024-05-22 corne/choc: remove some components from bom/pos files
    [corne choc.kicad_pcb]
2024-05-29 lily choc: move mounting holes
    [Lily58.kicad_pcb, Lily58.step, lily58 choc plates.kicad_pcb]
2024-05-29 lily choc: bump version
    [Lily58.kicad_pcb]
2024-07-06 lily choc: aadd choc to silkscreen
    [Lily58.kicad_pcb]
2024-07-06 lily choc: remove unused files
    [Lily58.step, smt2.dxf, spec.dxf]
2024-07-12 corne: add cherry version with leds
    [corne-cherry.kicad_pcb, corne-cherry.kicad_sch]
